bradjc/thermostat/README.md

thermostat
==========

Hardware and software for interfacing an 802.15.4 radio with a Nest thermostat and Liebert Mini-mate cooling unit.
