bradjc/thermostat/tinyos/apps/NestPassThrough/README

Program the NIB so that button presses on the thermostats work like they always
have.
