bradjc/thermostat/docs/ffc_thru-hole_10pos_0.100in.pdf

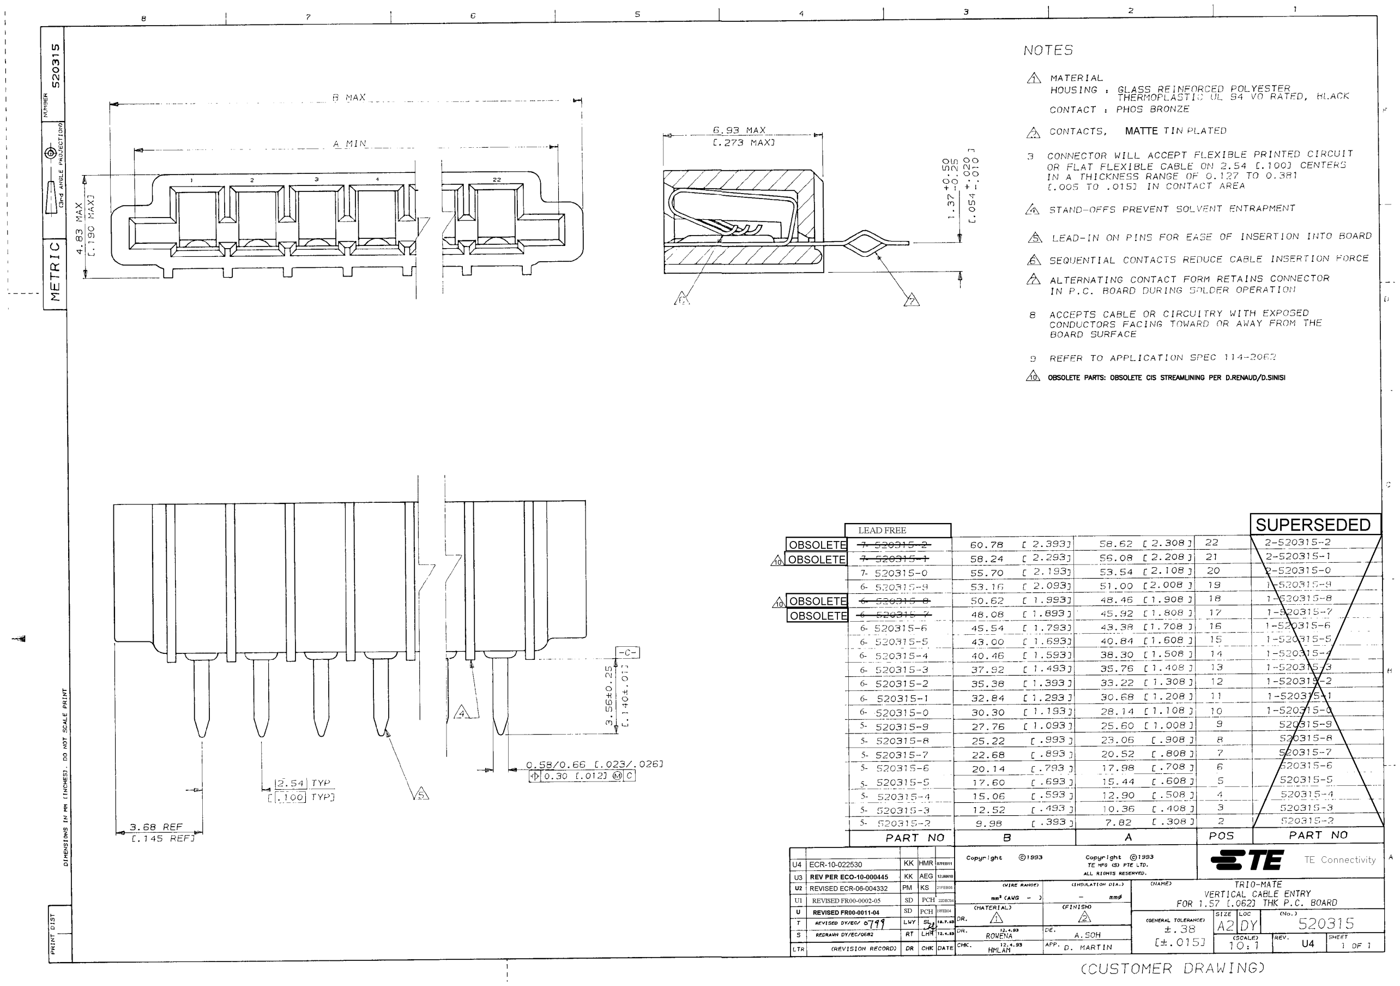
[picture p1: page 1]
