bradjc/thermostat/eagle/nest_interface/rev_a/nest_interface_a_mm.dxf

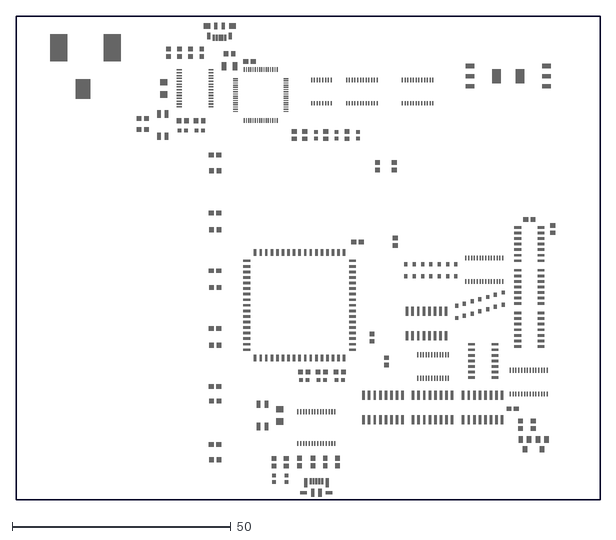
[picture p2: CAD file, 2013-02-01, an earlier design]
eagle/nest_interface/rev_a/nest_interface_a_mm.dxf
133.3 x 110.5
