bradjc/thermostat/eagle/nest_interface/rev_a/nest_interface_a.brd

## EAGLE design eagle/nest_interface/rev_a/nest_interface_a.brd (2013-02-01, an earlier design)

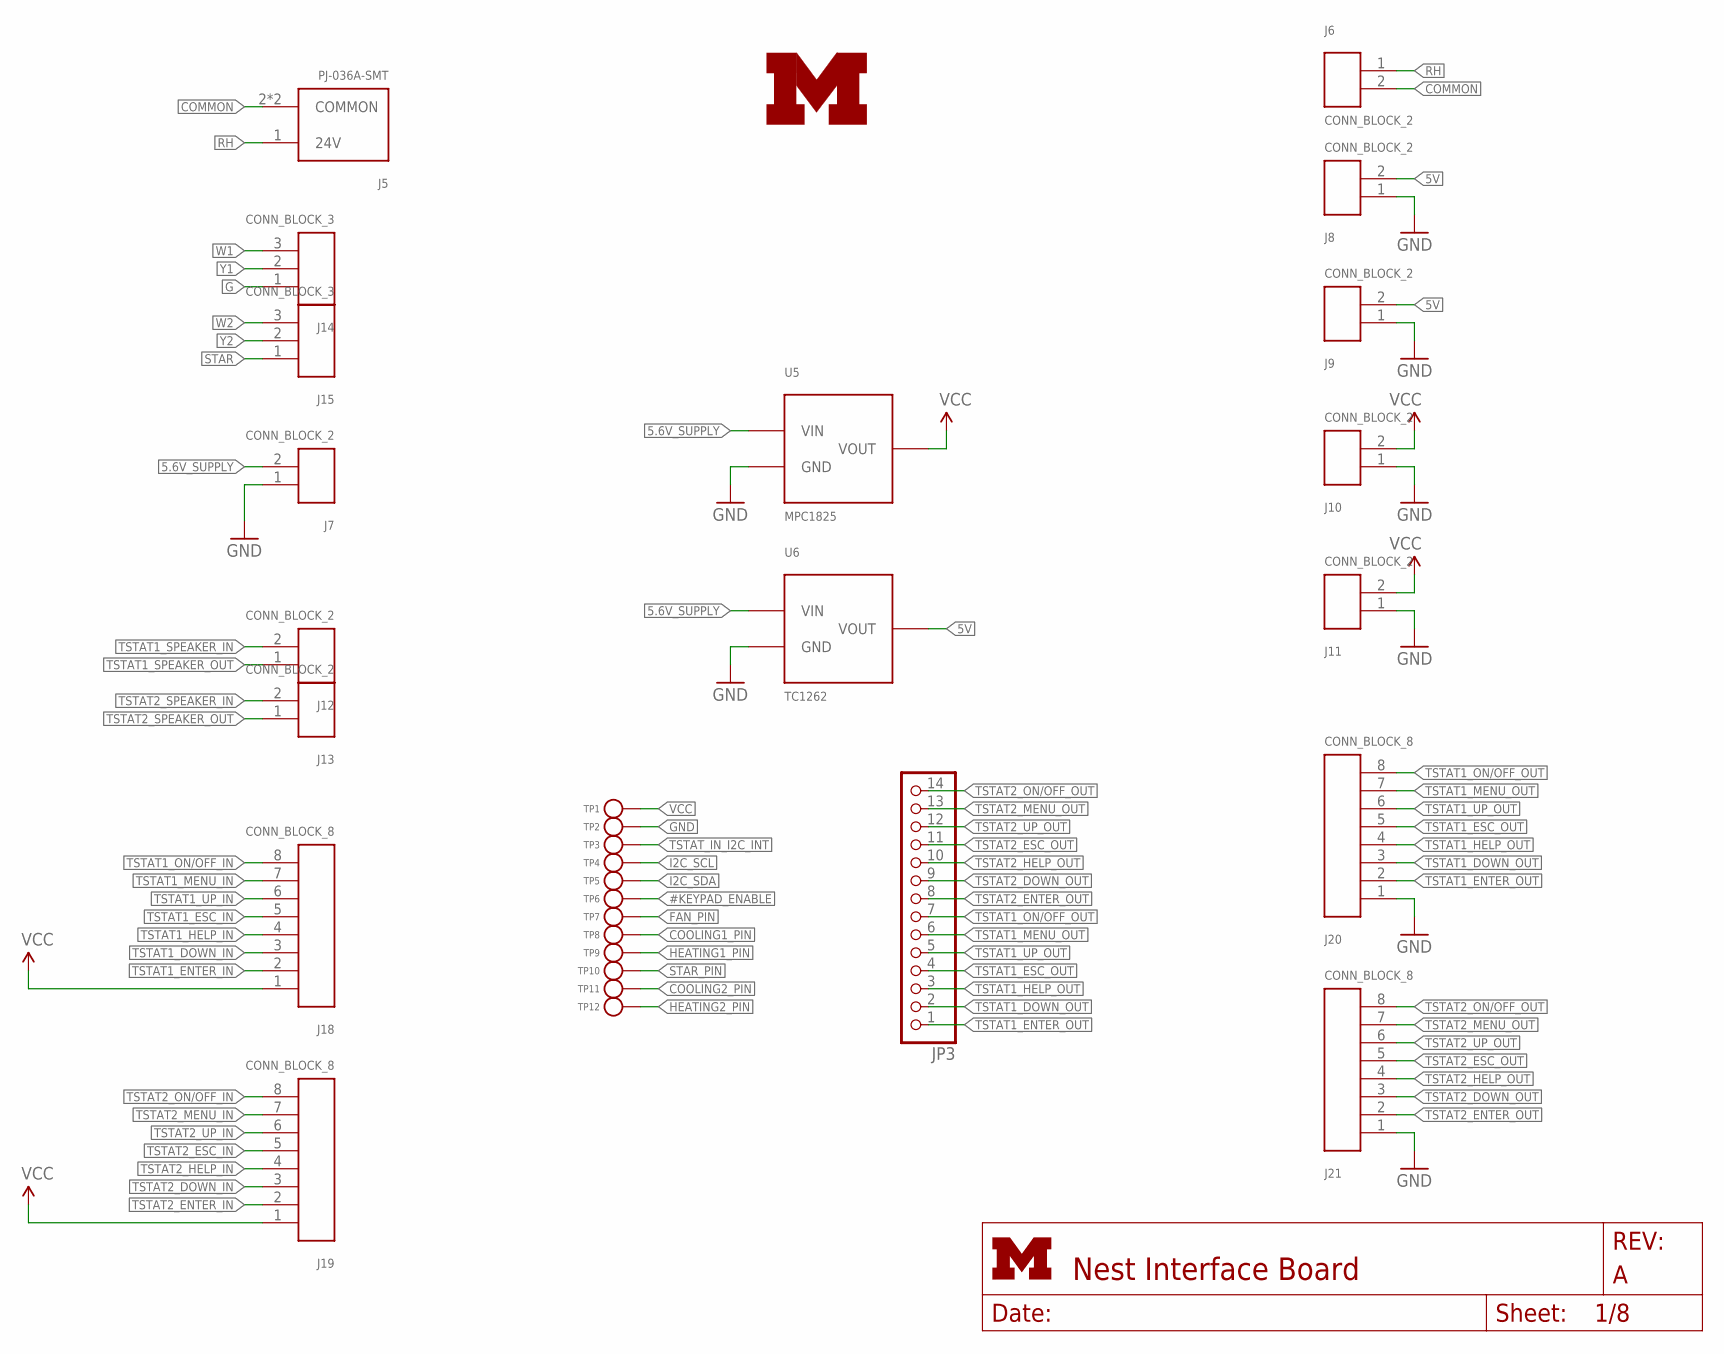
[picture p3: schematic nest_interface_a.sch, sheet 1]

Parts:
J5: PJ-036A-SMT; PJ-0361-SMT
J6, J7, J8, J9, J10, J11, J12, J13: CONN_BLOCK_2
J14, J15: CONN_BLOCK_3
J18, J19, J20, J21: CONN_BLOCK_8
JP3: PINHD-1X14; 1X14
TP1, TP2, TP3, TP4, TP5, TP6, TP7, TP8, TP9, TP10, TP11, TP12: TEST_POINT_0.040IN; TESTPOINT_0.040IN
U5: MPC1825; SOT-223-3
U6: TC1262; SOT-223-3
U$1: UMICH_SOLID_LARGE; UMICH_SOLID_350MIL

Connections:
5.6V_SUPPLY: J7.2, U5.1 (VIN), U6.1 (VIN)
5V: J8.2, J9.2, U6.3 (VOUT)
#KEYPAD_ENABLE: TP6.TESTPOINT; also elsewhere on the board
COMMON: J5.2 (COMMON), J5.3 (COMMON), J6.2; also elsewhere on the board
COOLING1_PIN: TP8.TESTPOINT; also elsewhere on the board
COOLING2_PIN: TP11.TESTPOINT; also elsewhere on the board
FAN_PIN: TP7.TESTPOINT; also elsewhere on the board
G: J14.1; also elsewhere on the board
GND: J7.1, J8.1, J9.1, J10.1, J11.1, J20.1, J21.1, TP2.TESTPOINT, U5.2 (GND), U5.4 (GND), U6.2 (GND), U6.4 (GND); also elsewhere on the board
HEATING1_PIN: TP9.TESTPOINT; also elsewhere on the board
HEATING2_PIN: TP12.TESTPOINT; also elsewhere on the board
I2C_SCL: TP4.TESTPOINT; also elsewhere on the board
I2C_SDA: TP5.TESTPOINT; also elsewhere on the board
RH: J5.1 (24V), J6.1
STAR: J15.1; also elsewhere on the board
STAR_PIN: TP10.TESTPOINT; also elsewhere on the board
TSTAT1_DOWN_IN: J18.3; also elsewhere on the board
TSTAT1_DOWN_OUT: J20.3, JP3.2; also elsewhere on the board
TSTAT1_ENTER_IN: J18.2; also elsewhere on the board
TSTAT1_ENTER_OUT: J20.2, JP3.1; also elsewhere on the board
TSTAT1_ESC_IN: J18.5; also elsewhere on the board
TSTAT1_ESC_OUT: J20.5, JP3.4; also elsewhere on the board
TSTAT1_HELP_IN: J18.4; also elsewhere on the board
TSTAT1_HELP_OUT: J20.4, JP3.3; also elsewhere on the board
TSTAT1_MENU_IN: J18.7; also elsewhere on the board
TSTAT1_MENU_OUT: J20.7, JP3.6; also elsewhere on the board
TSTAT1_ON/OFF_IN: J18.8; also elsewhere on the board
TSTAT1_ON/OFF_OUT: J20.8, JP3.7; also elsewhere on the board
TSTAT1_SPEAKER_IN: J12.2; also elsewhere on the board
TSTAT1_SPEAKER_OUT: J12.1; also elsewhere on the board
TSTAT1_UP_IN: J18.6; also elsewhere on the board
TSTAT1_UP_OUT: J20.6, JP3.5; also elsewhere on the board
TSTAT2_DOWN_IN: J19.3; also elsewhere on the board
TSTAT2_DOWN_OUT: J21.3, JP3.9; also elsewhere on the board
TSTAT2_ENTER_IN: J19.2; also elsewhere on the board
TSTAT2_ENTER_OUT: J21.2, JP3.8; also elsewhere on the board
TSTAT2_ESC_IN: J19.5; also elsewhere on the board
TSTAT2_ESC_OUT: J21.5, JP3.11; also elsewhere on the board
TSTAT2_HELP_IN: J19.4; also elsewhere on the board
TSTAT2_HELP_OUT: J21.4, JP3.10; also elsewhere on the board
TSTAT2_MENU_IN: J19.7; also elsewhere on the board
TSTAT2_MENU_OUT: J21.7, JP3.13; also elsewhere on the board
TSTAT2_ON/OFF_IN: J19.8; also elsewhere on the board
TSTAT2_ON/OFF_OUT: J21.8, JP3.14; also elsewhere on the board
TSTAT2_SPEAKER_IN: J13.2; also elsewhere on the board
TSTAT2_SPEAKER_OUT: J13.1; also elsewhere on the board
TSTAT2_UP_IN: J19.6; also elsewhere on the board
TSTAT2_UP_OUT: J21.6, JP3.12; also elsewhere on the board
TSTAT_IN_I2C_INT: TP3.TESTPOINT; also elsewhere on the board
VCC: J10.2, J11.2, J18.1, J19.1, TP1.TESTPOINT, U5.3 (VOUT); also elsewhere on the board
W1: J14.3; also elsewhere on the board
W2: J15.3; also elsewhere on the board
Y1: J14.2; also elsewhere on the board
Y2: J15.2; also elsewhere on the board

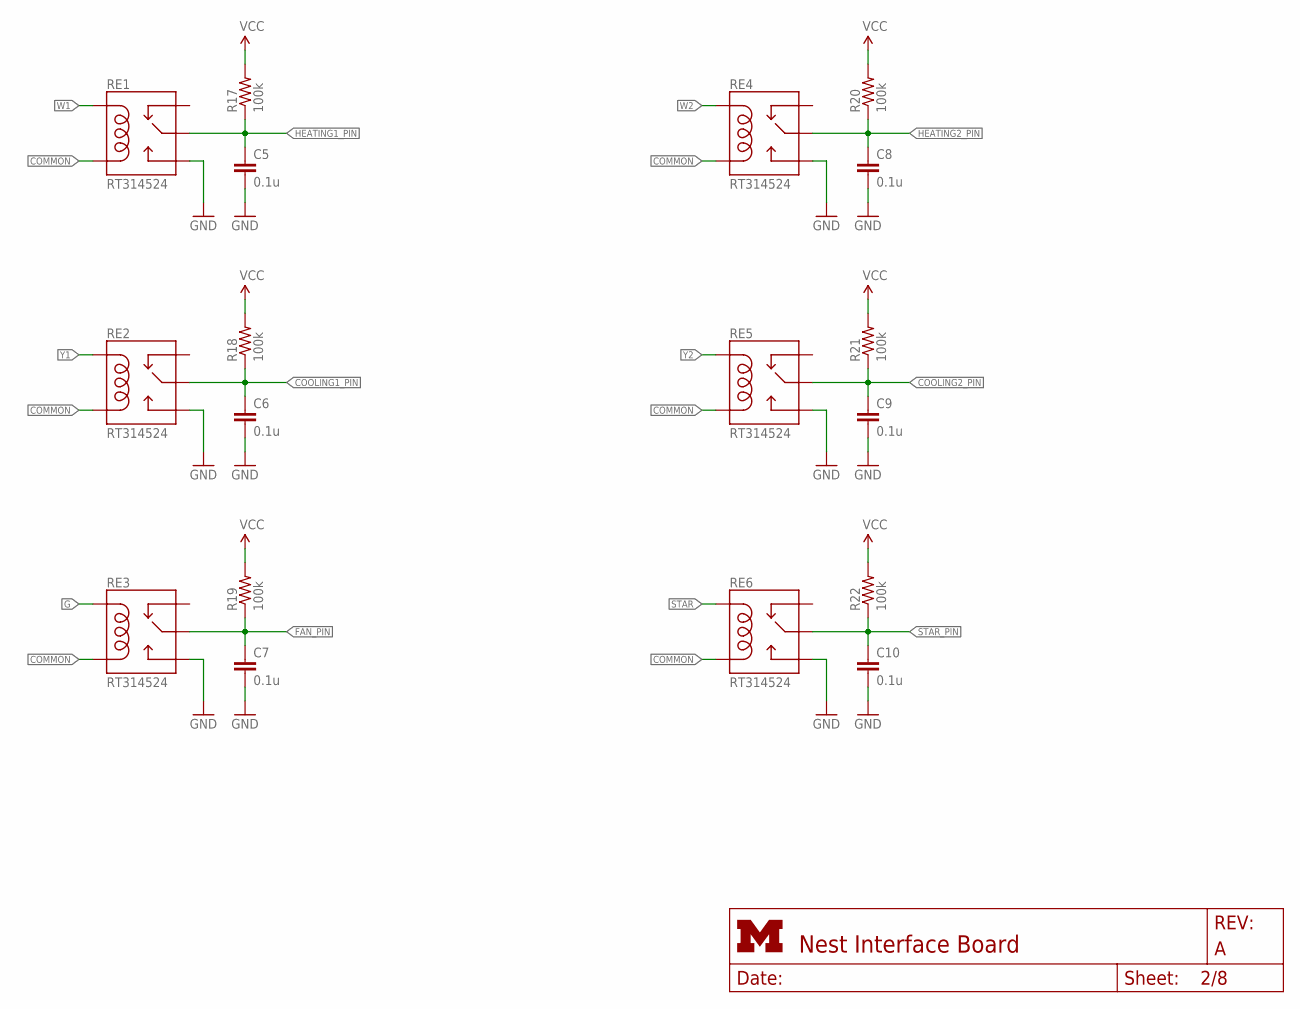
[picture p4: schematic nest_interface_a.sch, sheet 2, Relays]

Parts:
C5, C6, C7, C8, C9, C10: 0.1u; C0603
R17, R18, R19, R20, R21, R22: 100k; R0603
RE1, RE2, RE3, RE4, RE5, RE6: RT314524; S0418-CA

Connections:
COMMON: RE1.A2 (COIL2), RE2.A2 (COIL2), RE3.A2 (COIL2), RE4.A2 (COIL2), RE5.A2 (COIL2), RE6.A2 (COIL2); also elsewhere on the board
COOLING1_PIN: C6.1, R18.1, RE2.COMMON1 (MAIN), RE2.COMMON2 (MAIN); also elsewhere on the board
COOLING2_PIN: C9.1, R21.1, RE5.COMMON1 (MAIN), RE5.COMMON2 (MAIN); also elsewhere on the board
FAN_PIN: C7.1, R19.1, RE3.COMMON1 (MAIN), RE3.COMMON2 (MAIN); also elsewhere on the board
G: RE3.A1 (COIL1); also elsewhere on the board
GND: C5.2, C6.2, C7.2, C8.2, C9.2, C10.2, RE1.NO1 (NO), RE1.NO2 (NO), RE2.NO1 (NO), RE2.NO2 (NO), RE3.NO1 (NO), RE3.NO2 (NO), RE4.NO1 (NO), RE4.NO2 (NO), RE5.NO1 (NO), RE5.NO2 (NO), RE6.NO1 (NO), RE6.NO2 (NO); also elsewhere on the board
HEATING1_PIN: C5.1, R17.1, RE1.COMMON1 (MAIN), RE1.COMMON2 (MAIN); also elsewhere on the board
HEATING2_PIN: C8.1, R20.1, RE4.COMMON1 (MAIN), RE4.COMMON2 (MAIN); also elsewhere on the board
STAR: RE6.A1 (COIL1); also elsewhere on the board
STAR_PIN: C10.1, R22.1, RE6.COMMON1 (MAIN), RE6.COMMON2 (MAIN); also elsewhere on the board
VCC: R17.2, R18.2, R19.2, R20.2, R21.2, R22.2; also elsewhere on the board
W1: RE1.A1 (COIL1); also elsewhere on the board
W2: RE4.A1 (COIL1); also elsewhere on the board
Y1: RE2.A1 (COIL1); also elsewhere on the board
Y2: RE5.A1 (COIL1); also elsewhere on the board

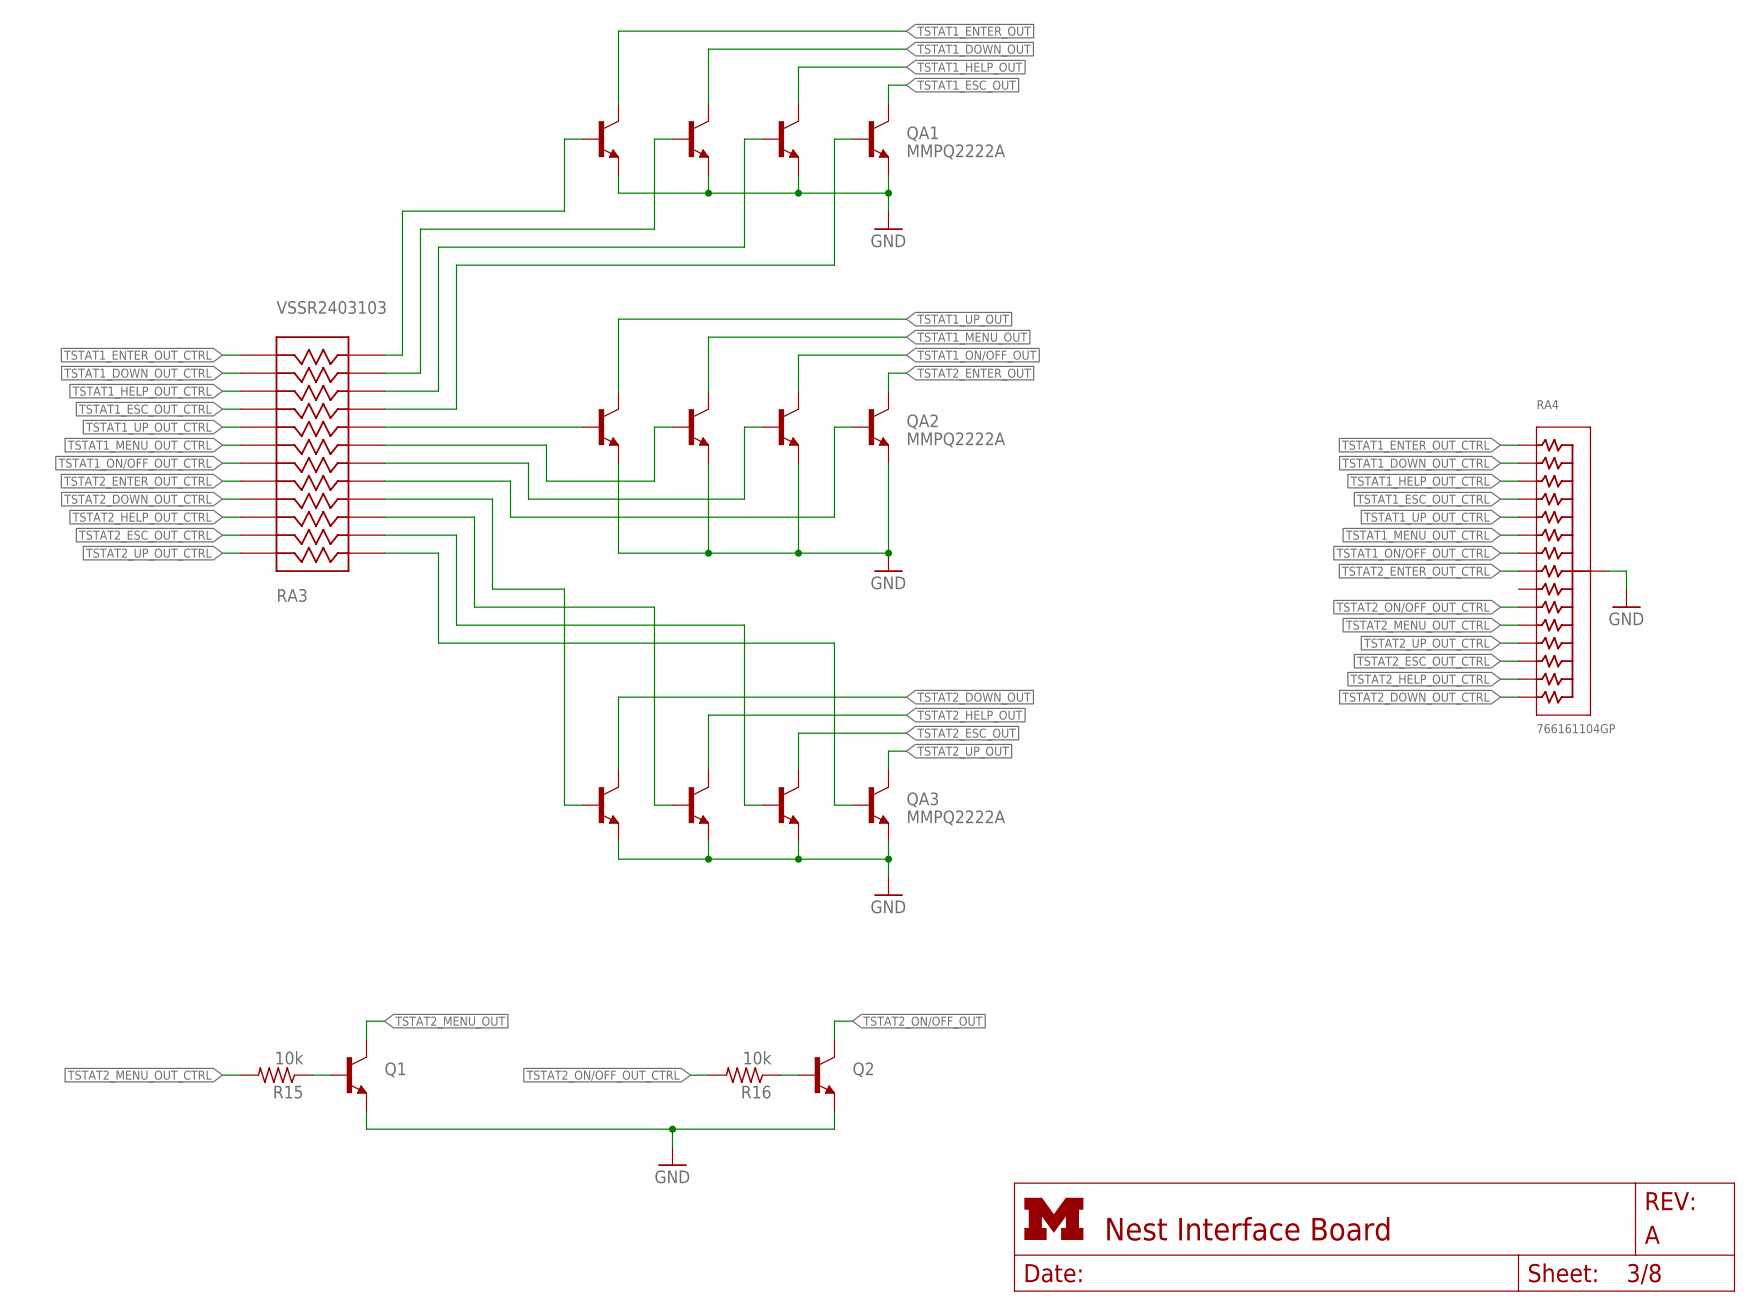
[picture p5: schematic nest_interface_a.sch, sheet 3, Wire interfacing]

Parts:
Q1, Q2: TRANSISTOR_NPNSOT23; SOT23; DIGIKEY 568-1636-1-ND
QA1, QA3: MMPQ2222A; SOIC-16; DIGIKEY MMPQ2222ACT-ND
QA2: MMPQ2222A; SOIC-16
R15, R16: 10k; R0603
RA3: VSSR2403103; LSSOP-24
RA4: 766161104GP; SOIC-16

Connections:
GND: Q1.2 (E), Q2.2 (E), QA1.10 (E4), QA1.12 (E3), QA1.14 (E2), QA1.16 (E1), QA2.10 (E4), QA2.12 (E3), QA2.14 (E2), QA2.16 (E1), QA3.10 (E4), QA3.12 (E3), QA3.14 (E2), QA3.16 (E1), RA4.16 (OUT); also elsewhere on the board
unnamed: QA2.11 (B3), RA3.19
unnamed: QA1.13 (B2), RA3.14
unnamed: QA1.11 (B3), RA3.15
unnamed: QA1.9 (B4), RA3.16
unnamed: QA3.9 (B4), RA3.24
unnamed: QA3.15 (B1), RA3.21
unnamed: QA3.13 (B2), RA3.22
unnamed: QA3.11 (B3), RA3.23
unnamed: Q1.1 (B), R15.1
unnamed: Q2.1 (B), R16.1
unnamed: QA1.15 (B1), RA3.13
unnamed: QA2.15 (B1), RA3.17
unnamed: QA2.9 (B4), RA3.20
unnamed: QA2.13 (B2), RA3.18
TSTAT1_DOWN_OUT: QA1.3 (C2), QA1.4 (C2); also elsewhere on the board
TSTAT1_DOWN_OUT_CTRL: RA3.11, RA4.2; also elsewhere on the board
TSTAT1_ENTER_OUT: QA1.1 (C1), QA1.2 (C1); also elsewhere on the board
TSTAT1_ENTER_OUT_CTRL: RA3.12, RA4.1; also elsewhere on the board
TSTAT1_ESC_OUT: QA1.7 (C4), QA1.8 (C4); also elsewhere on the board
TSTAT1_ESC_OUT_CTRL: RA3.9, RA4.4; also elsewhere on the board
TSTAT1_HELP_OUT: QA1.5 (C3), QA1.6 (C3); also elsewhere on the board
TSTAT1_HELP_OUT_CTRL: RA3.10, RA4.3; also elsewhere on the board
TSTAT1_MENU_OUT: QA2.3 (C2), QA2.4 (C2); also elsewhere on the board
TSTAT1_MENU_OUT_CTRL: RA3.7, RA4.6; also elsewhere on the board
TSTAT1_ON/OFF_OUT: QA2.5 (C3), QA2.6 (C3); also elsewhere on the board
TSTAT1_ON/OFF_OUT_CTRL: RA3.6, RA4.7; also elsewhere on the board
TSTAT1_UP_OUT: QA2.1 (C1), QA2.2 (C1); also elsewhere on the board
TSTAT1_UP_OUT_CTRL: RA3.8, RA4.5; also elsewhere on the board
TSTAT2_DOWN_OUT: QA3.1 (C1), QA3.2 (C1); also elsewhere on the board
TSTAT2_DOWN_OUT_CTRL: RA3.4, RA4.15; also elsewhere on the board
TSTAT2_ENTER_OUT: QA2.7 (C4), QA2.8 (C4); also elsewhere on the board
TSTAT2_ENTER_OUT_CTRL: RA3.5, RA4.8; also elsewhere on the board
TSTAT2_ESC_OUT: QA3.5 (C3), QA3.6 (C3); also elsewhere on the board
TSTAT2_ESC_OUT_CTRL: RA3.2, RA4.13; also elsewhere on the board
TSTAT2_HELP_OUT: QA3.3 (C2), QA3.4 (C2); also elsewhere on the board
TSTAT2_HELP_OUT_CTRL: RA3.3, RA4.14; also elsewhere on the board
TSTAT2_MENU_OUT: Q1.3 (C); also elsewhere on the board
TSTAT2_MENU_OUT_CTRL: R15.2, RA4.11; also elsewhere on the board
TSTAT2_ON/OFF_OUT: Q2.3 (C); also elsewhere on the board
TSTAT2_ON/OFF_OUT_CTRL: R16.2, RA4.10; also elsewhere on the board
TSTAT2_UP_OUT: QA3.7 (C4), QA3.8 (C4); also elsewhere on the board
TSTAT2_UP_OUT_CTRL: RA3.1, RA4.12; also elsewhere on the board

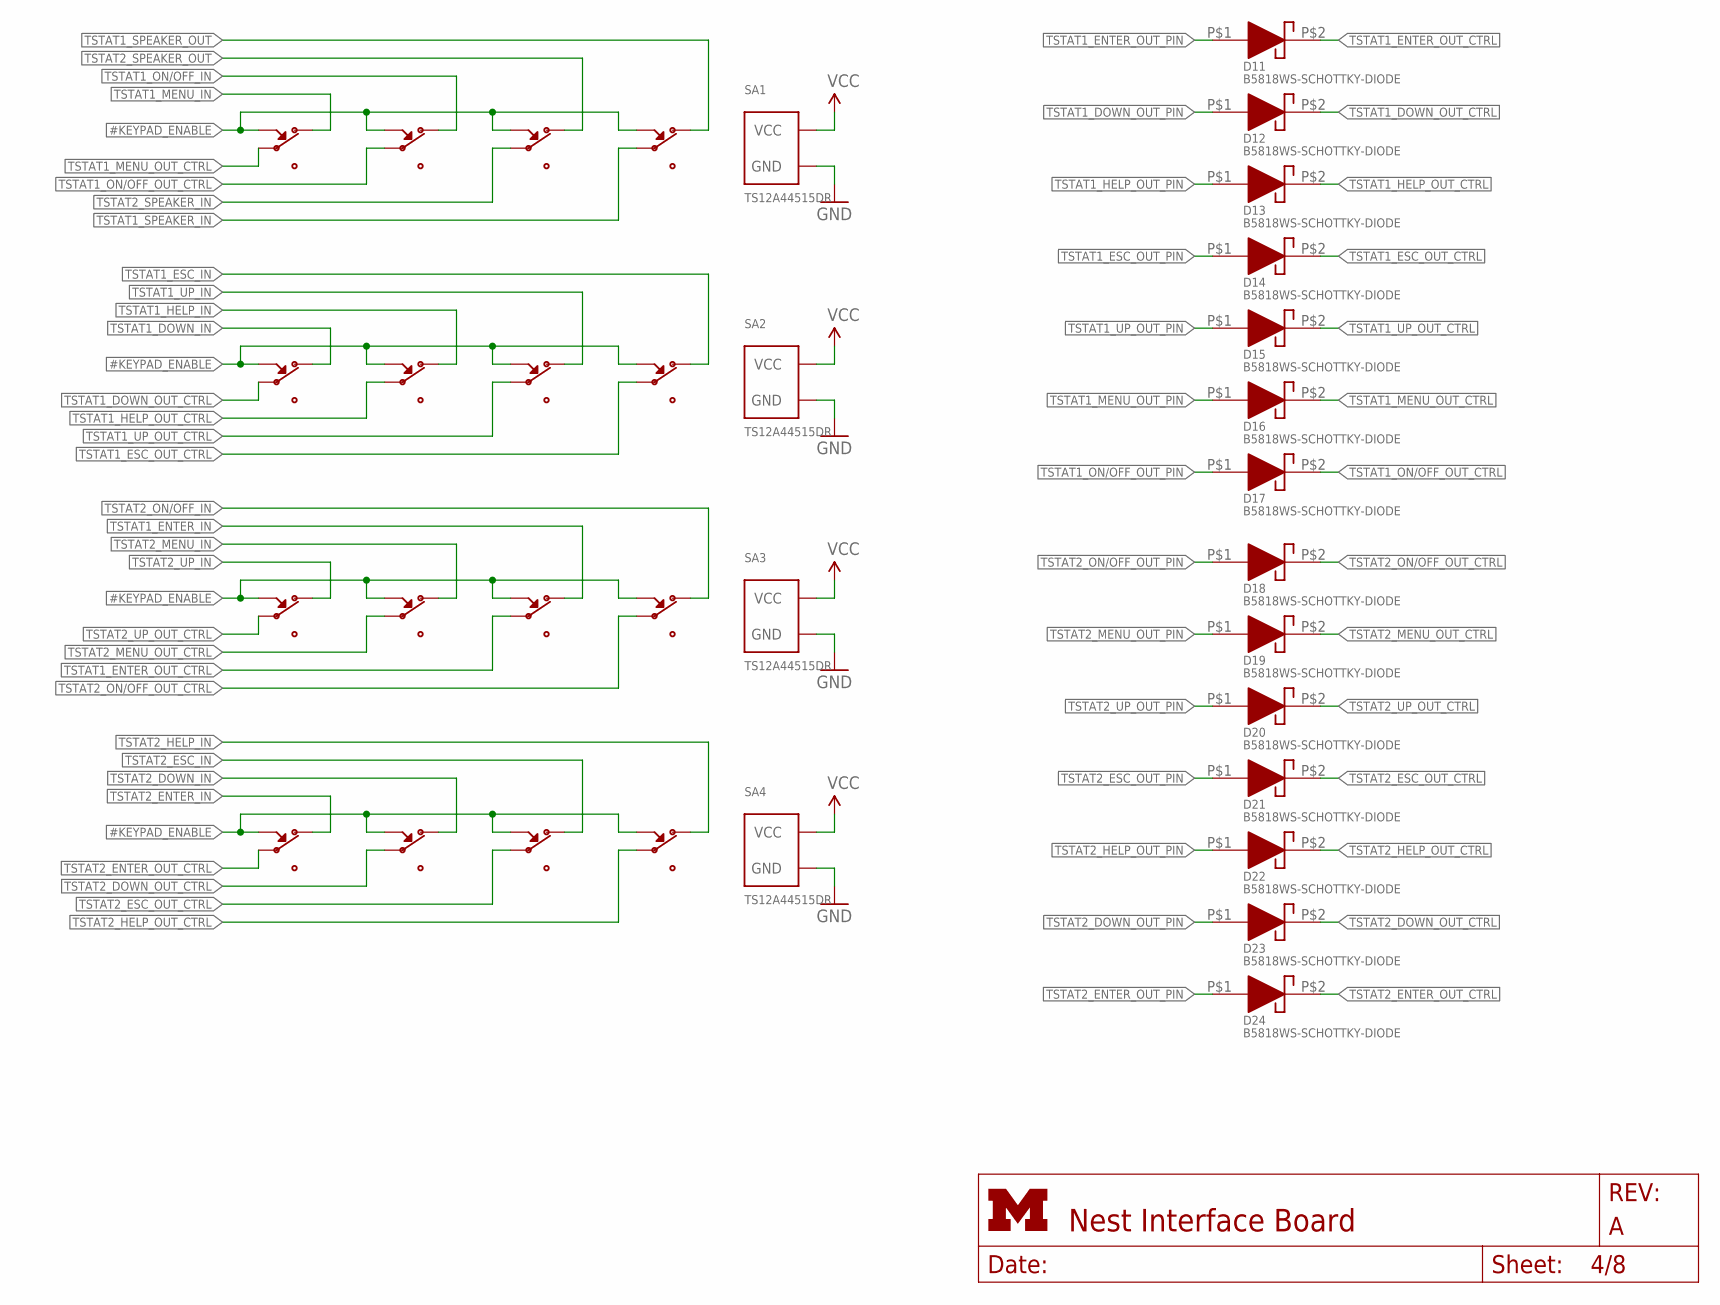
[picture p6: schematic nest_interface_a.sch, sheet 4, Input buttons from thermostat]

Parts:
D11, D12, D13, D14, D15, D16, D17, D18, D19, D20, D21, D22, D23, D24: B5818WS-SCHOTTKY-DIODE; SOD-323
SA1, SA2, SA3, SA4: TS12A44515DR; SOIC-14

Connections:
#KEYPAD_ENABLE: SA1.5 (IN2), SA1.6 (IN3), SA1.12 (IN4), SA1.13 (IN1), SA2.5 (IN2), SA2.6 (IN3), SA2.12 (IN4), SA2.13 (IN1), SA3.5 (IN2), SA3.6 (IN3), SA3.12 (IN4), SA3.13 (IN1), SA4.5 (IN2), SA4.6 (IN3), SA4.12 (IN4), SA4.13 (IN1); also elsewhere on the board
GND: SA1.7 (GND), SA2.7 (GND), SA3.7 (GND), SA4.7 (GND); also elsewhere on the board
TSTAT1_DOWN_IN: SA2.1 (NC1); also elsewhere on the board
TSTAT1_DOWN_OUT_CTRL: D12.P$2 (C), SA2.2 (COM1); also elsewhere on the board
TSTAT1_DOWN_OUT_PIN: D12.P$1 (A); also elsewhere on the board
TSTAT1_ENTER_IN: SA3.8 (NC3); also elsewhere on the board
TSTAT1_ENTER_OUT_CTRL: D11.P$2 (C), SA3.9 (COM3); also elsewhere on the board
TSTAT1_ENTER_OUT_PIN: D11.P$1 (A); also elsewhere on the board
TSTAT1_ESC_IN: SA2.11 (NC4); also elsewhere on the board
TSTAT1_ESC_OUT_CTRL: D14.P$2 (C), SA2.10 (COM4); also elsewhere on the board
TSTAT1_ESC_OUT_PIN: D14.P$1 (A); also elsewhere on the board
TSTAT1_HELP_IN: SA2.3 (NC2); also elsewhere on the board
TSTAT1_HELP_OUT_CTRL: D13.P$2 (C), SA2.4 (COM2); also elsewhere on the board
TSTAT1_HELP_OUT_PIN: D13.P$1 (A); also elsewhere on the board
TSTAT1_MENU_IN: SA1.1 (NC1); also elsewhere on the board
TSTAT1_MENU_OUT_CTRL: D16.P$2 (C), SA1.2 (COM1); also elsewhere on the board
TSTAT1_MENU_OUT_PIN: D16.P$1 (A); also elsewhere on the board
TSTAT1_ON/OFF_IN: SA1.3 (NC2); also elsewhere on the board
TSTAT1_ON/OFF_OUT_CTRL: D17.P$2 (C), SA1.4 (COM2); also elsewhere on the board
TSTAT1_ON/OFF_OUT_PIN: D17.P$1 (A); also elsewhere on the board
TSTAT1_SPEAKER_IN: SA1.10 (COM4); also elsewhere on the board
TSTAT1_SPEAKER_OUT: SA1.11 (NC4); also elsewhere on the board
TSTAT1_UP_IN: SA2.8 (NC3); also elsewhere on the board
TSTAT1_UP_OUT_CTRL: D15.P$2 (C), SA2.9 (COM3); also elsewhere on the board
TSTAT1_UP_OUT_PIN: D15.P$1 (A); also elsewhere on the board
TSTAT2_DOWN_IN: SA4.3 (NC2); also elsewhere on the board
TSTAT2_DOWN_OUT_CTRL: D23.P$2 (C), SA4.4 (COM2); also elsewhere on the board
TSTAT2_DOWN_OUT_PIN: D23.P$1 (A); also elsewhere on the board
TSTAT2_ENTER_IN: SA4.1 (NC1); also elsewhere on the board
TSTAT2_ENTER_OUT_CTRL: D24.P$2 (C), SA4.2 (COM1); also elsewhere on the board
TSTAT2_ENTER_OUT_PIN: D24.P$1 (A); also elsewhere on the board
TSTAT2_ESC_IN: SA4.8 (NC3); also elsewhere on the board
TSTAT2_ESC_OUT_CTRL: D21.P$2 (C), SA4.9 (COM3); also elsewhere on the board
TSTAT2_ESC_OUT_PIN: D21.P$1 (A); also elsewhere on the board
TSTAT2_HELP_IN: SA4.11 (NC4); also elsewhere on the board
TSTAT2_HELP_OUT_CTRL: D22.P$2 (C), SA4.10 (COM4); also elsewhere on the board
TSTAT2_HELP_OUT_PIN: D22.P$1 (A); also elsewhere on the board
TSTAT2_MENU_IN: SA3.3 (NC2); also elsewhere on the board
TSTAT2_MENU_OUT_CTRL: D19.P$2 (C), SA3.4 (COM2); also elsewhere on the board
TSTAT2_MENU_OUT_PIN: D19.P$1 (A); also elsewhere on the board
TSTAT2_ON/OFF_IN: SA3.11 (NC4); also elsewhere on the board
TSTAT2_ON/OFF_OUT_CTRL: D18.P$2 (C), SA3.10 (COM4); also elsewhere on the board
TSTAT2_ON/OFF_OUT_PIN: D18.P$1 (A); also elsewhere on the board
TSTAT2_SPEAKER_IN: SA1.9 (COM3); also elsewhere on the board
TSTAT2_SPEAKER_OUT: SA1.8 (NC3); also elsewhere on the board
TSTAT2_UP_IN: SA3.1 (NC1); also elsewhere on the board
TSTAT2_UP_OUT_CTRL: D20.P$2 (C), SA3.2 (COM1); also elsewhere on the board
TSTAT2_UP_OUT_PIN: D20.P$1 (A); also elsewhere on the board
VCC: SA1.14 (VCC), SA2.14 (VCC), SA3.14 (VCC), SA4.14 (VCC); also elsewhere on the board

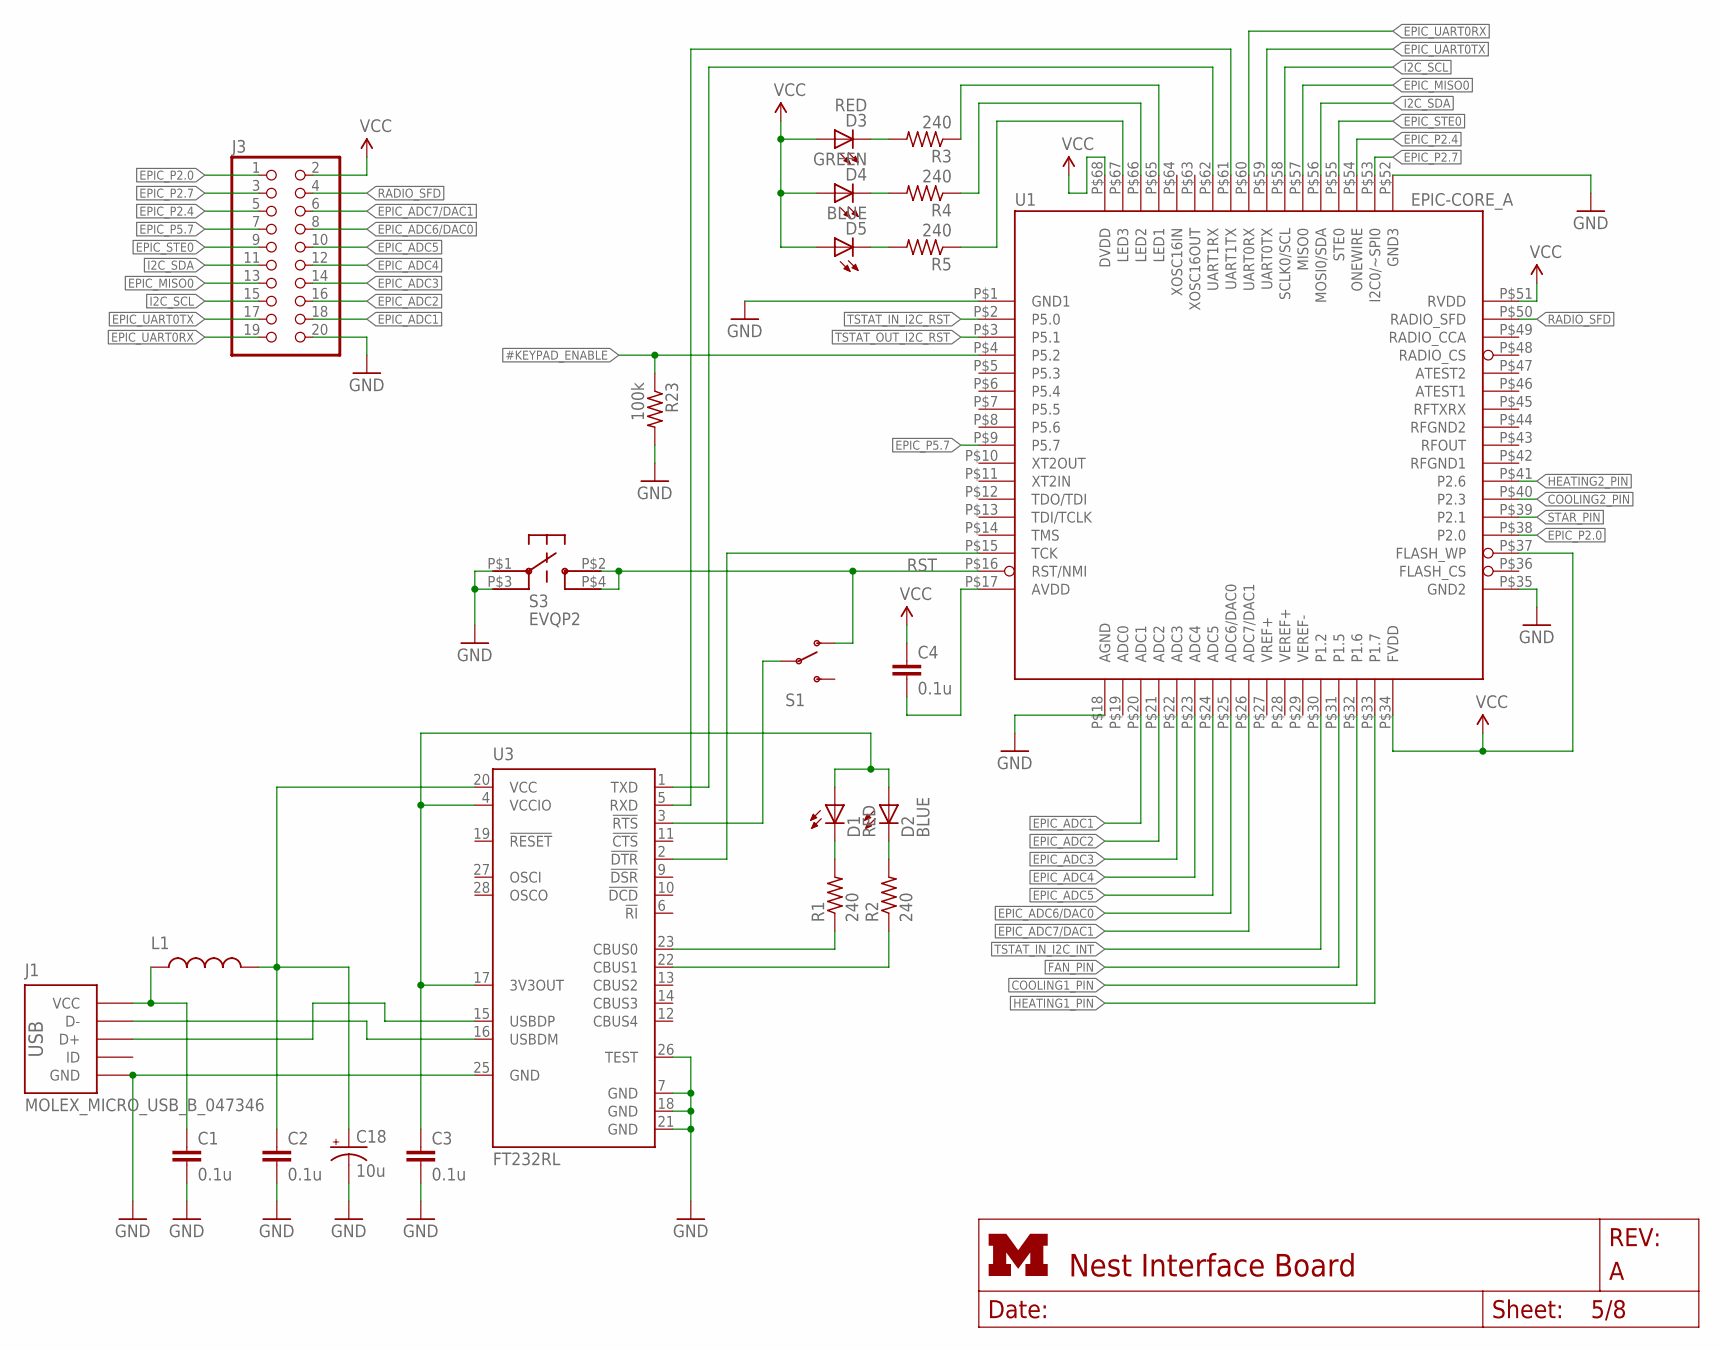
[picture p7: schematic nest_interface_a.sch, sheet 5, EPIC and programming circuit]

Parts:
C1, C2, C3, C4: 0.1u; C0603
C18: 10u; EIA3216; DIGIKEY 478-1655-1-ND
D1, D3: RED; LED-0603
D2, D5: BLUE; LED-0603
D4: GREEN; LED-0603
J1: MOLEX_MICRO_USB_B_047346
J3: PINHD-2X10; 2X10
L1: INDUCTOR0603; 0603; DIGIKEY 240-2373-1-ND
R1, R2, R3, R4, R5: 240; R0603
R23: 100k; R0603
S1: SWITCH-SPSTPTH; SWITCH-SPDT; DIGIKEY EG1903-ND
S3: EVQP2; DIGIKEY P11084SCT-ND
U1: EPIC-CORE_A; EPIC-LCC68
U3: FT232RL; SSOP28; DIGIKEY 768-1007-1-ND

Connections:
#KEYPAD_ENABLE: R23.1, U1.P$4 (P5.2); also elsewhere on the board
COOLING1_PIN: U1.P$32 (P1.6); also elsewhere on the board
COOLING2_PIN: U1.P$40 (P2.3); also elsewhere on the board
EPIC_ADC1: J3.18, U1.P$20 (ADC1)
EPIC_ADC2: J3.16, U1.P$21 (ADC2)
EPIC_ADC3: J3.14, U1.P$22 (ADC3)
EPIC_ADC4: J3.12, U1.P$23 (ADC4)
EPIC_ADC5: J3.10, U1.P$24 (ADC5)
EPIC_ADC6/DAC0: J3.8, U1.P$25 (ADC6/DAC0)
EPIC_ADC7/DAC1: J3.6, U1.P$26 (ADC7/DAC1)
EPIC_MISO0: J3.13, U1.P$57 (MISO0)
EPIC_P2.0: J3.1, U1.P$38 (P2.0)
EPIC_P2.4: J3.5, U1.P$54 (ONEWIRE)
EPIC_P2.7: J3.3, U1.P$53 (I2C0/~SPI0)
EPIC_P5.7: J3.7, U1.P$9 (P5.7)
EPIC_STE0: J3.9, U1.P$55 (STE0)
EPIC_UART0RX: J3.19, U1.P$60 (UART0RX)
EPIC_UART0TX: J3.17, U1.P$59 (UART0TX)
FAN_PIN: U1.P$31 (P1.5); also elsewhere on the board
GND: C1.2, C2.2, C3.2, C18.C (-), J1.GND, J3.20, R23.2, S3.P$1, S3.P$3, U1.P$1 (GND1), U1.P$18 (AGND), U1.P$35 (GND2), U1.P$52 (GND3), U3.7 (GND), U3.18 (GND), U3.21 (GND), U3.25 (GND), U3.26 (TEST); also elsewhere on the board
HEATING1_PIN: U1.P$33 (P1.7); also elsewhere on the board
HEATING2_PIN: U1.P$41 (P2.6); also elsewhere on the board
I2C_SCL: J3.15, U1.P$58 (SCLK0/SCL); also elsewhere on the board
I2C_SDA: J3.11, U1.P$56 (MOSI0/SDA); also elsewhere on the board
unnamed: C1.1, J1.VCC, L1.1
unnamed: D1.C, R1.2
unnamed: J1.D-, U3.16 (USBDM)
unnamed: J1.D+, U3.15 (USBDP)
unnamed: C2.1, C18.A (+), L1.2, U3.20 (VCC)
unnamed: D2.C, R2.2
unnamed: U1.P$62 (UART1RX), U3.1 (TXD)
unnamed: R1.1, U3.23 (CBUS0)
unnamed: R2.1, U3.22 (CBUS1)
unnamed: U1.P$61 (UART1TX), U3.5 (RXD)
unnamed: U1.P$15 (TCK), U3.2 (!DTR)
unnamed: C3.1, D1.A, D2.A, U3.4 (VCCIO), U3.17 (3V3OUT)
unnamed: C4.2, U1.P$17 (AVDD)
unnamed: D3.C, R3.2
unnamed: D4.C, R4.2
unnamed: D5.C, R5.2
unnamed: R5.1, U1.P$67 (LED3)
unnamed: R4.1, U1.P$66 (LED2)
unnamed: R3.1, U1.P$65 (LED1)
RADIO_SFD: J3.4, U1.P$50 (RADIO_SFD)
RST: S1.1 (O), S3.P$2, S3.P$4, U1.P$16 (RST/NMI)
RST_USB: S1.2, U3.3 (!RTS)
STAR_PIN: U1.P$39 (P2.1); also elsewhere on the board
TSTAT_IN_I2C_INT: U1.P$30 (P1.2); also elsewhere on the board
TSTAT_IN_I2C_RST: U1.P$2 (P5.0); also elsewhere on the board
TSTAT_OUT_I2C_RST: U1.P$3 (P5.1); also elsewhere on the board
VCC: C4.1, D3.A, D4.A, D5.A, J3.2, U1.P$34 (FVDD), U1.P$37 (FLASH_WP), U1.P$51 (RVDD), U1.P$68 (DVDD); also elsewhere on the board

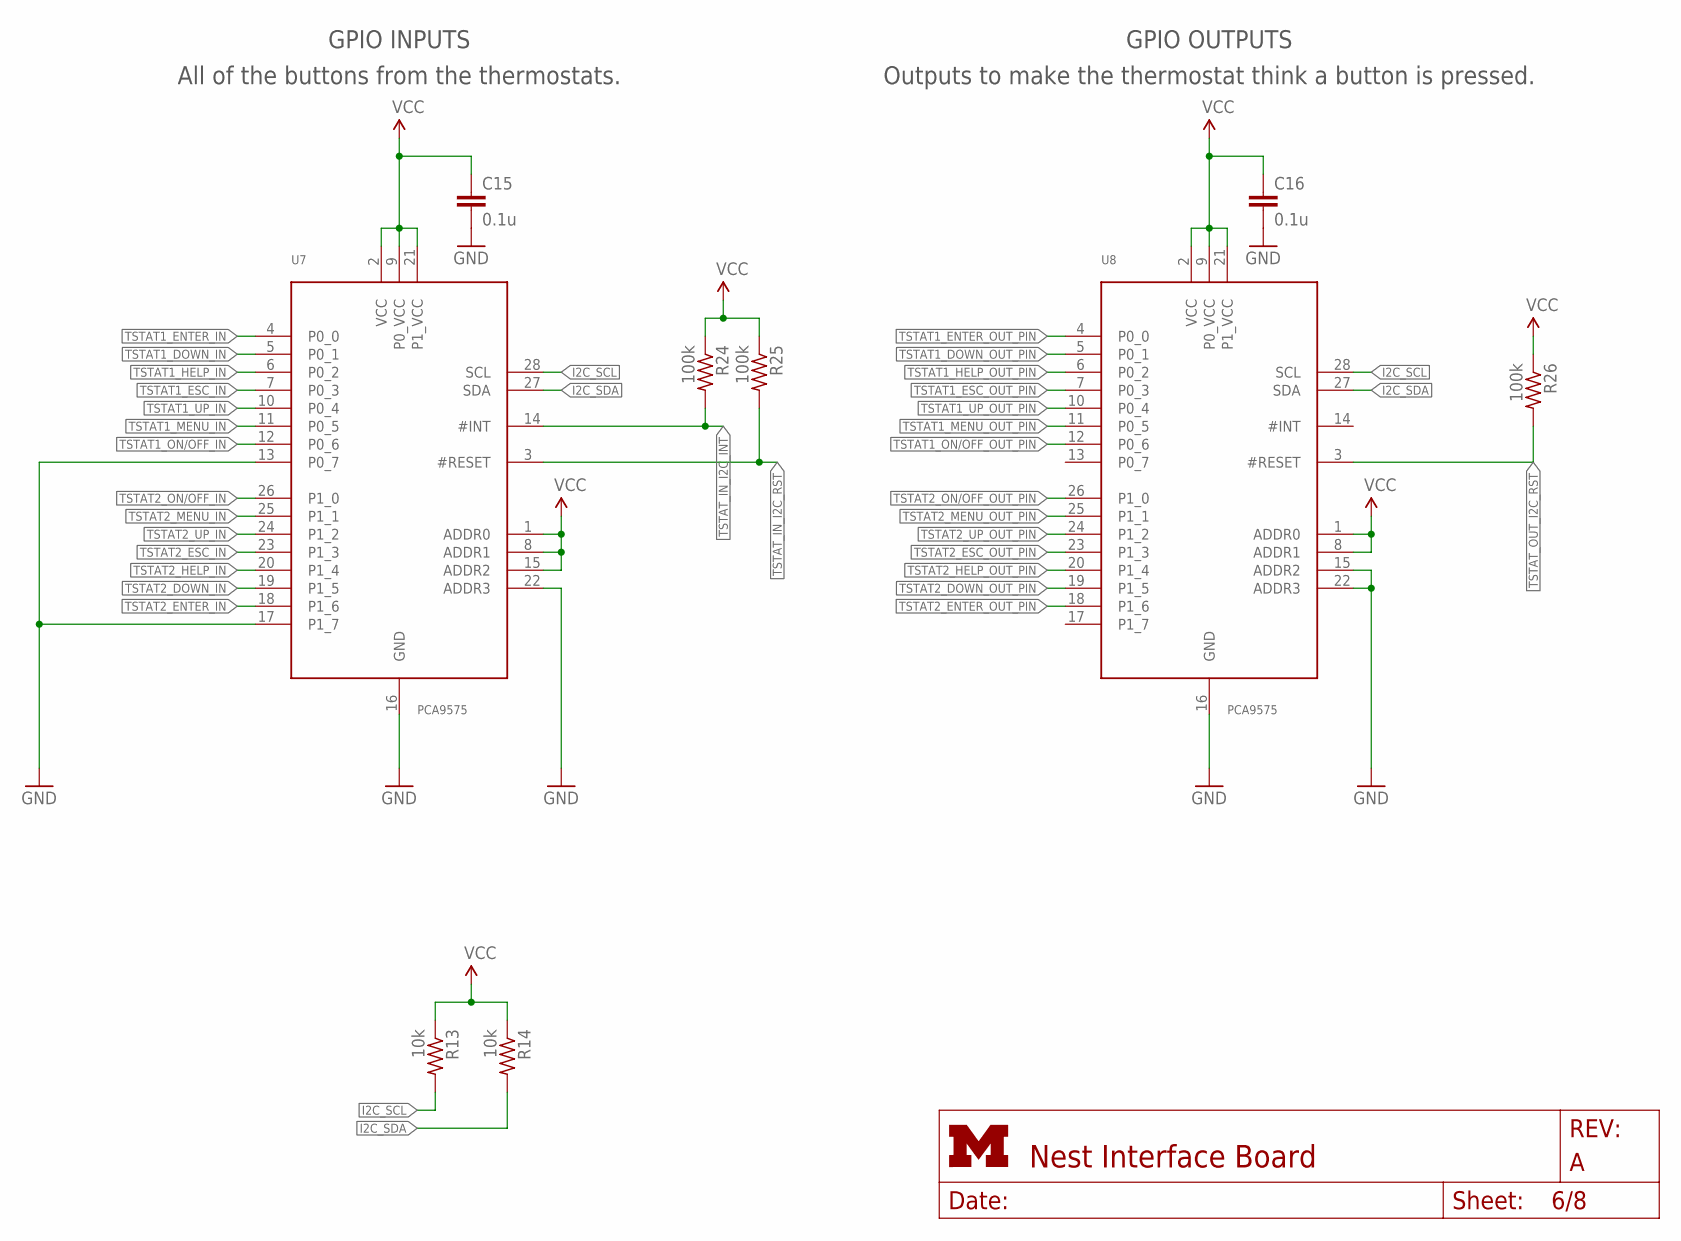
[picture p8: schematic nest_interface_a.sch, sheet 6, GPIO Extenders]

Parts:
C15, C16: 0.1u; C0603
R13, R14: 10k; R0603
R24, R25, R26: 100k; R0603
U7, U8: PCA9575; TSSOP28

Connections:
GND: C15.2, C16.2, U7.13 (P0_7), U7.16 (GND), U7.17 (P1_7), U7.22 (ADDR3), U8.15 (ADDR2), U8.16 (GND), U8.22 (ADDR3); also elsewhere on the board
I2C_SCL: R13.2, U7.28 (SCL), U8.28 (SCL); also elsewhere on the board
I2C_SDA: R14.2, U7.27 (SDA), U8.27 (SDA); also elsewhere on the board
TSTAT1_DOWN_IN: U7.5 (P0_1); also elsewhere on the board
TSTAT1_DOWN_OUT_PIN: U8.5 (P0_1); also elsewhere on the board
TSTAT1_ENTER_IN: U7.4 (P0_0); also elsewhere on the board
TSTAT1_ENTER_OUT_PIN: U8.4 (P0_0); also elsewhere on the board
TSTAT1_ESC_IN: U7.7 (P0_3); also elsewhere on the board
TSTAT1_ESC_OUT_PIN: U8.7 (P0_3); also elsewhere on the board
TSTAT1_HELP_IN: U7.6 (P0_2); also elsewhere on the board
TSTAT1_HELP_OUT_PIN: U8.6 (P0_2); also elsewhere on the board
TSTAT1_MENU_IN: U7.11 (P0_5); also elsewhere on the board
TSTAT1_MENU_OUT_PIN: U8.11 (P0_5); also elsewhere on the board
TSTAT1_ON/OFF_IN: U7.12 (P0_6); also elsewhere on the board
TSTAT1_ON/OFF_OUT_PIN: U8.12 (P0_6); also elsewhere on the board
TSTAT1_UP_IN: U7.10 (P0_4); also elsewhere on the board
TSTAT1_UP_OUT_PIN: U8.10 (P0_4); also elsewhere on the board
TSTAT2_DOWN_IN: U7.19 (P1_5); also elsewhere on the board
TSTAT2_DOWN_OUT_PIN: U8.19 (P1_5); also elsewhere on the board
TSTAT2_ENTER_IN: U7.18 (P1_6); also elsewhere on the board
TSTAT2_ENTER_OUT_PIN: U8.18 (P1_6); also elsewhere on the board
TSTAT2_ESC_IN: U7.23 (P1_3); also elsewhere on the board
TSTAT2_ESC_OUT_PIN: U8.23 (P1_3); also elsewhere on the board
TSTAT2_HELP_IN: U7.20 (P1_4); also elsewhere on the board
TSTAT2_HELP_OUT_PIN: U8.20 (P1_4); also elsewhere on the board
TSTAT2_MENU_IN: U7.25 (P1_1); also elsewhere on the board
TSTAT2_MENU_OUT_PIN: U8.25 (P1_1); also elsewhere on the board
TSTAT2_ON/OFF_IN: U7.26 (P1_0); also elsewhere on the board
TSTAT2_ON/OFF_OUT_PIN: U8.26 (P1_0); also elsewhere on the board
TSTAT2_UP_IN: U7.24 (P1_2); also elsewhere on the board
TSTAT2_UP_OUT_PIN: U8.24 (P1_2); also elsewhere on the board
TSTAT_IN_I2C_INT: R24.2, U7.14 (#INT); also elsewhere on the board
TSTAT_IN_I2C_RST: R25.2, U7.3 (#RESET); also elsewhere on the board
TSTAT_OUT_I2C_RST: R26.2, U8.3 (#RESET); also elsewhere on the board
VCC: C15.1, C16.1, R13.1, R14.1, R24.1, R25.1, R26.1, U7.1 (ADDR0), U7.2 (VCC), U7.8 (ADDR1), U7.9 (P0_VCC), U7.15 (ADDR2), U7.21 (P1_VCC), U8.1 (ADDR0), U8.2 (VCC), U8.8 (ADDR1), U8.9 (P0_VCC), U8.21 (P1_VCC); also elsewhere on the board

Notes on the sheet:
GPIO INPUTS
All of the buttons from the thermostats.
GPIO OUTPUTS
Outputs to make the thermostat think a button is pressed.
