bradjc/thermostat/eagle/nest_interface/rev_a/nest_interface_a.brd

## EAGLE design eagle/nest_interface/rev_a/nest_interface_a.brd (continued)

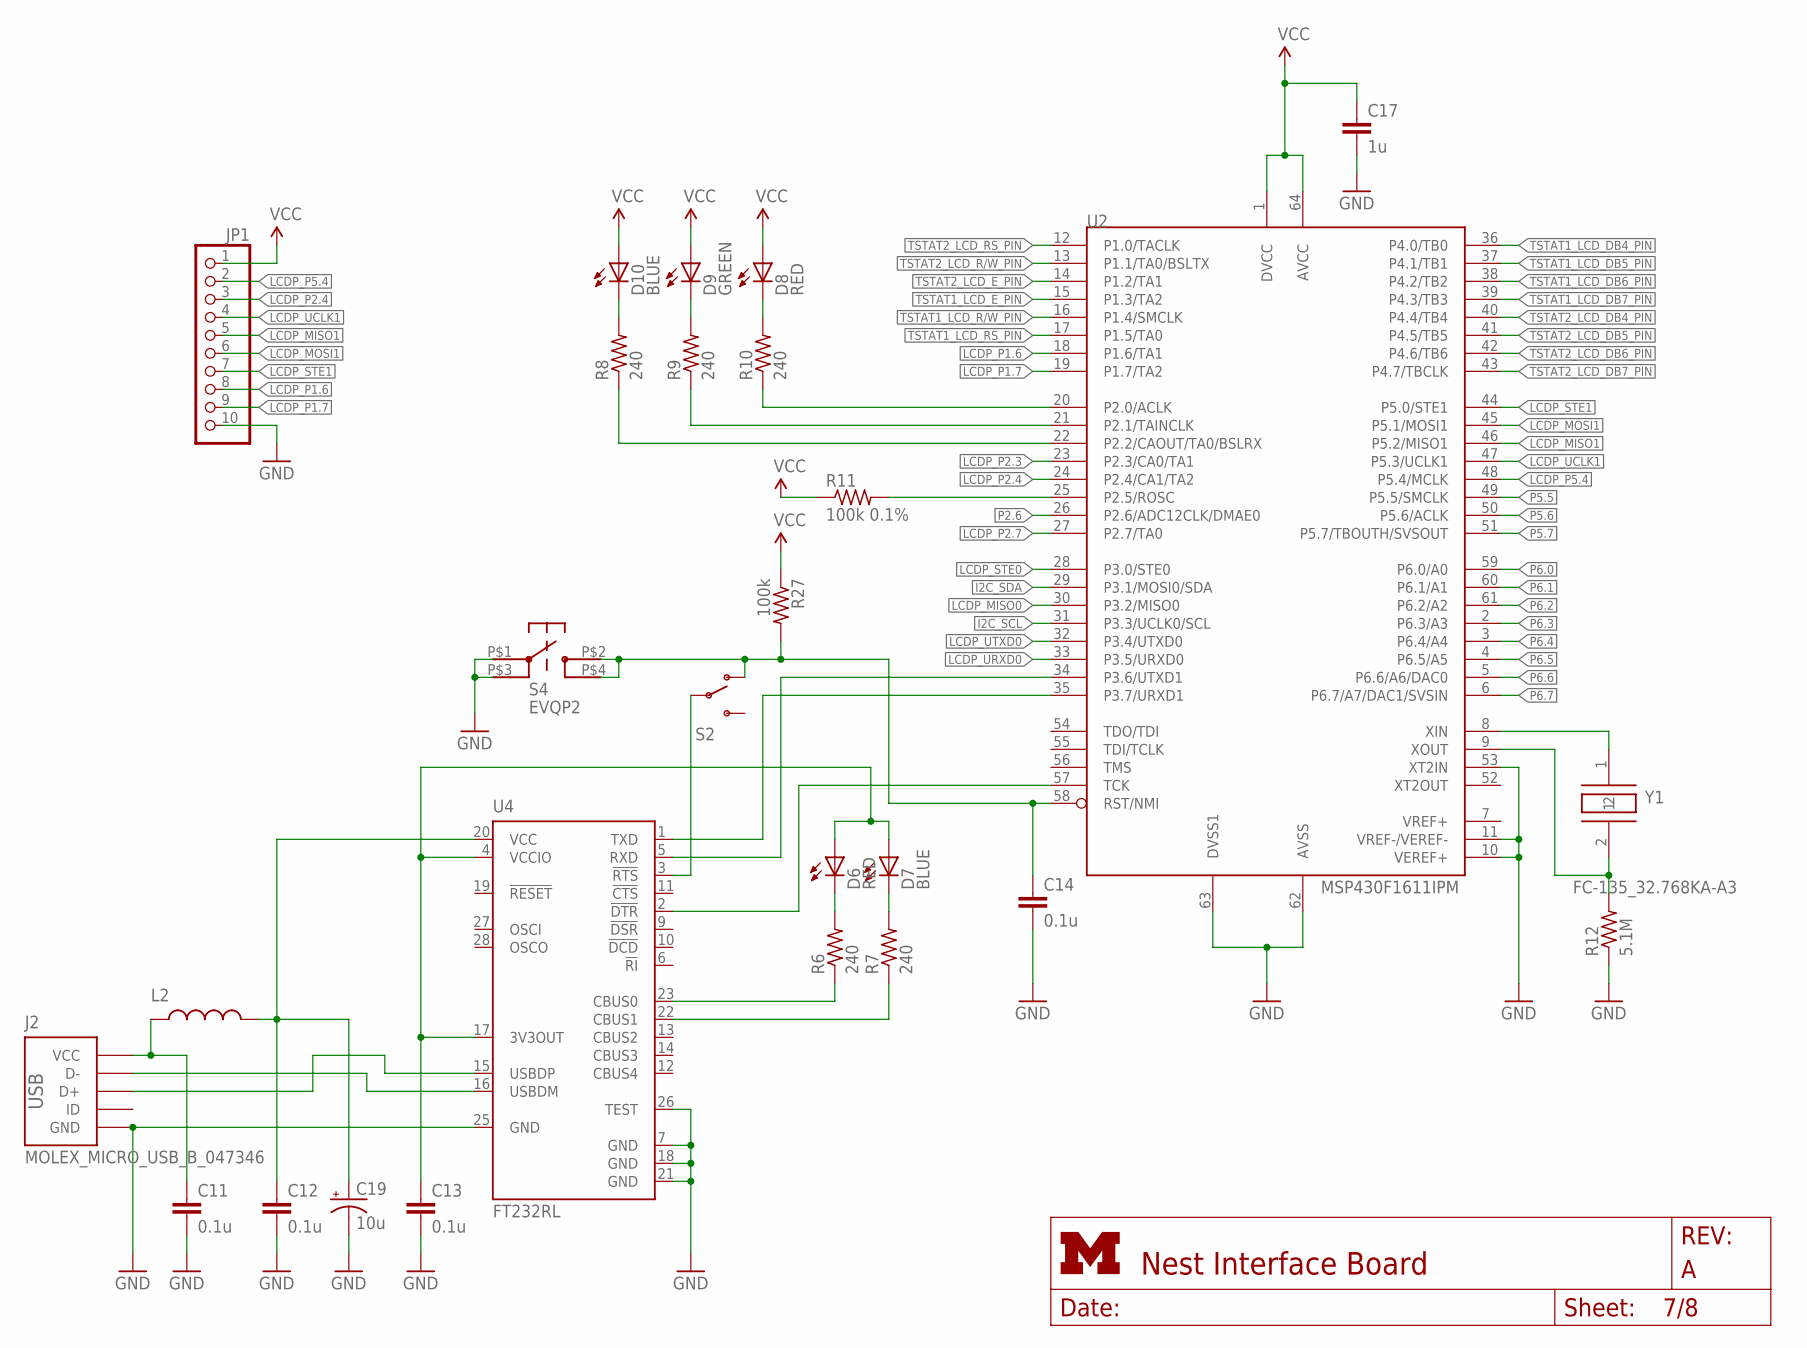
[picture p9: schematic nest_interface_a.sch, sheet 7, LCD Sniffer]

Parts:
C11, C12, C13, C14: 0.1u; C0603
C17: 1u; C0603
C19: 10u; EIA3216; DIGIKEY 478-1655-1-ND
D6, D8: RED; LED-0603
D7, D10: BLUE; LED-0603
D9: GREEN; LED-0603
J2: MOLEX_MICRO_USB_B_047346
JP1: PINHD-1X10; 1X10
L2: INDUCTOR0603; 0603; DIGIKEY 240-2373-1-ND
R6, R7, R8, R9, R10: 240; R0603
R11: 100k 0.1%; R0603
R12: 5.1M; R0603
R27: 100k; R0603
S2: SWITCH-SPSTPTH; SWITCH-SPDT; DIGIKEY EG1903-ND
S4: EVQP2; DIGIKEY P11084SCT-ND
U2: MSP430F1611IPM; PM/PAG64
U4: FT232RL; SSOP28; DIGIKEY 768-1007-1-ND
Y1: FC-135_32.768KA-A3; FC-135; DIGIKEY 535-9543-1-ND

Connections:
GND: C11.2, C12.2, C13.2, C14.2, C17.2, C19.C (-), J2.GND, JP1.10, R12.1, S4.P$1, S4.P$3, U2.10 (VEREF+), U2.11 (VREF-/VEREF-), U2.53 (XT2IN), U2.62 (AVSS), U2.63 (DVSS1), U4.7 (GND), U4.18 (GND), U4.21 (GND), U4.25 (GND), U4.26 (TEST); also elsewhere on the board
I2C_SCL: U2.31 (P3.3/UCLK0/SCL); also elsewhere on the board
I2C_SDA: U2.29 (P3.1/MOSI0/SDA); also elsewhere on the board
LCDP_MISO0: U2.30 (P3.2/MISO0)
LCDP_MISO1: JP1.5, U2.46 (P5.2/MISO1)
LCDP_MOSI1: JP1.6, U2.45 (P5.1/MOSI1)
LCDP_P1.6: JP1.8, U2.18 (P1.6/TA1)
LCDP_P1.7: JP1.9, U2.19 (P1.7/TA2)
LCDP_P2.3: U2.23 (P2.3/CA0/TA1)
LCDP_P2.4: JP1.3, U2.24 (P2.4/CA1/TA2)
LCDP_P2.7: U2.27 (P2.7/TA0)
LCDP_P5.4: JP1.2, U2.48 (P5.4/MCLK)
LCDP_STE0: U2.28 (P3.0/STE0)
LCDP_STE1: JP1.7, U2.44 (P5.0/STE1)
LCDP_UCLK1: JP1.4, U2.47 (P5.3/UCLK1)
LCDP_URXD0: U2.33 (P3.5/URXD0)
LCDP_UTXD0: U2.32 (P3.4/UTXD0)
unnamed: R10.1, U2.20 (P2.0/ACLK)
unnamed: D8.C, R10.2
unnamed: U2.8 (XIN), Y1.1
unnamed: C11.1, J2.VCC, L2.1
unnamed: J2.D-, U4.16 (USBDM)
unnamed: J2.D+, U4.15 (USBDP)
unnamed: C12.1, C19.A (+), L2.2, U4.20 (VCC)
unnamed: R6.1, U4.23 (CBUS0)
unnamed: R7.1, U4.22 (CBUS1)
unnamed: D6.C, R6.2
unnamed: D7.C, R7.2
unnamed: U2.35 (P3.7/URXD1), U4.1 (TXD)
unnamed: U2.34 (P3.6/UTXD1), U4.5 (RXD)
unnamed: U2.57 (TCK), U4.2 (!DTR)
unnamed: C13.1, D6.A, D7.A, U4.4 (VCCIO), U4.17 (3V3OUT)
unnamed: R12.2, U2.9 (XOUT), Y1.2
unnamed: D9.C, R9.2
unnamed: R11.2, U2.25 (P2.5/ROSC)
unnamed: D10.C, R8.2
unnamed: R9.1, U2.21 (P2.1/TAINCLK)
unnamed: R8.1, U2.22 (P2.2/CAOUT/TA0/BSLRX)
P2.6: U2.26 (P2.6/ADC12CLK/DMAE0)
P5.5: U2.49 (P5.5/SMCLK)
P5.6: U2.50 (P5.6/ACLK)
P5.7: U2.51 (P5.7/TBOUTH/SVSOUT)
P6.0: U2.59 (P6.0/A0)
P6.1: U2.60 (P6.1/A1)
P6.2: U2.61 (P6.2/A2)
P6.3: U2.2 (P6.3/A3)
P6.4: U2.3 (P6.4/A4)
P6.5: U2.4 (P6.5/A5)
P6.6: U2.5 (P6.6/A6/DAC0)
P6.7: U2.6 (P6.7/A7/DAC1/SVSIN)
RST1: C14.1, R27.2, S2.1 (O), S4.P$2, S4.P$4, U2.58 (RST/NMI)
RST_USB1: S2.2, U4.3 (!RTS)
TSTAT1_LCD_DB4_PIN: U2.36 (P4.0/TB0); also elsewhere on the board
TSTAT1_LCD_DB5_PIN: U2.37 (P4.1/TB1); also elsewhere on the board
TSTAT1_LCD_DB6_PIN: U2.38 (P4.2/TB2); also elsewhere on the board
TSTAT1_LCD_DB7_PIN: U2.39 (P4.3/TB3); also elsewhere on the board
TSTAT1_LCD_E_PIN: U2.15 (P1.3/TA2); also elsewhere on the board
TSTAT1_LCD_R/W_PIN: U2.16 (P1.4/SMCLK); also elsewhere on the board
TSTAT1_LCD_RS_PIN: U2.17 (P1.5/TA0); also elsewhere on the board
TSTAT2_LCD_DB4_PIN: U2.40 (P4.4/TB4); also elsewhere on the board
TSTAT2_LCD_DB5_PIN: U2.41 (P4.5/TB5); also elsewhere on the board
TSTAT2_LCD_DB6_PIN: U2.42 (P4.6/TB6); also elsewhere on the board
TSTAT2_LCD_DB7_PIN: U2.43 (P4.7/TBCLK); also elsewhere on the board
TSTAT2_LCD_E_PIN: U2.14 (P1.2/TA1); also elsewhere on the board
TSTAT2_LCD_R/W_PIN: U2.13 (P1.1/TA0/BSLTX); also elsewhere on the board
TSTAT2_LCD_RS_PIN: U2.12 (P1.0/TACLK); also elsewhere on the board
VCC: C17.1, D8.A, D9.A, D10.A, JP1.1, R11.1, R27.1, U2.1 (DVCC), U2.64 (AVCC); also elsewhere on the board

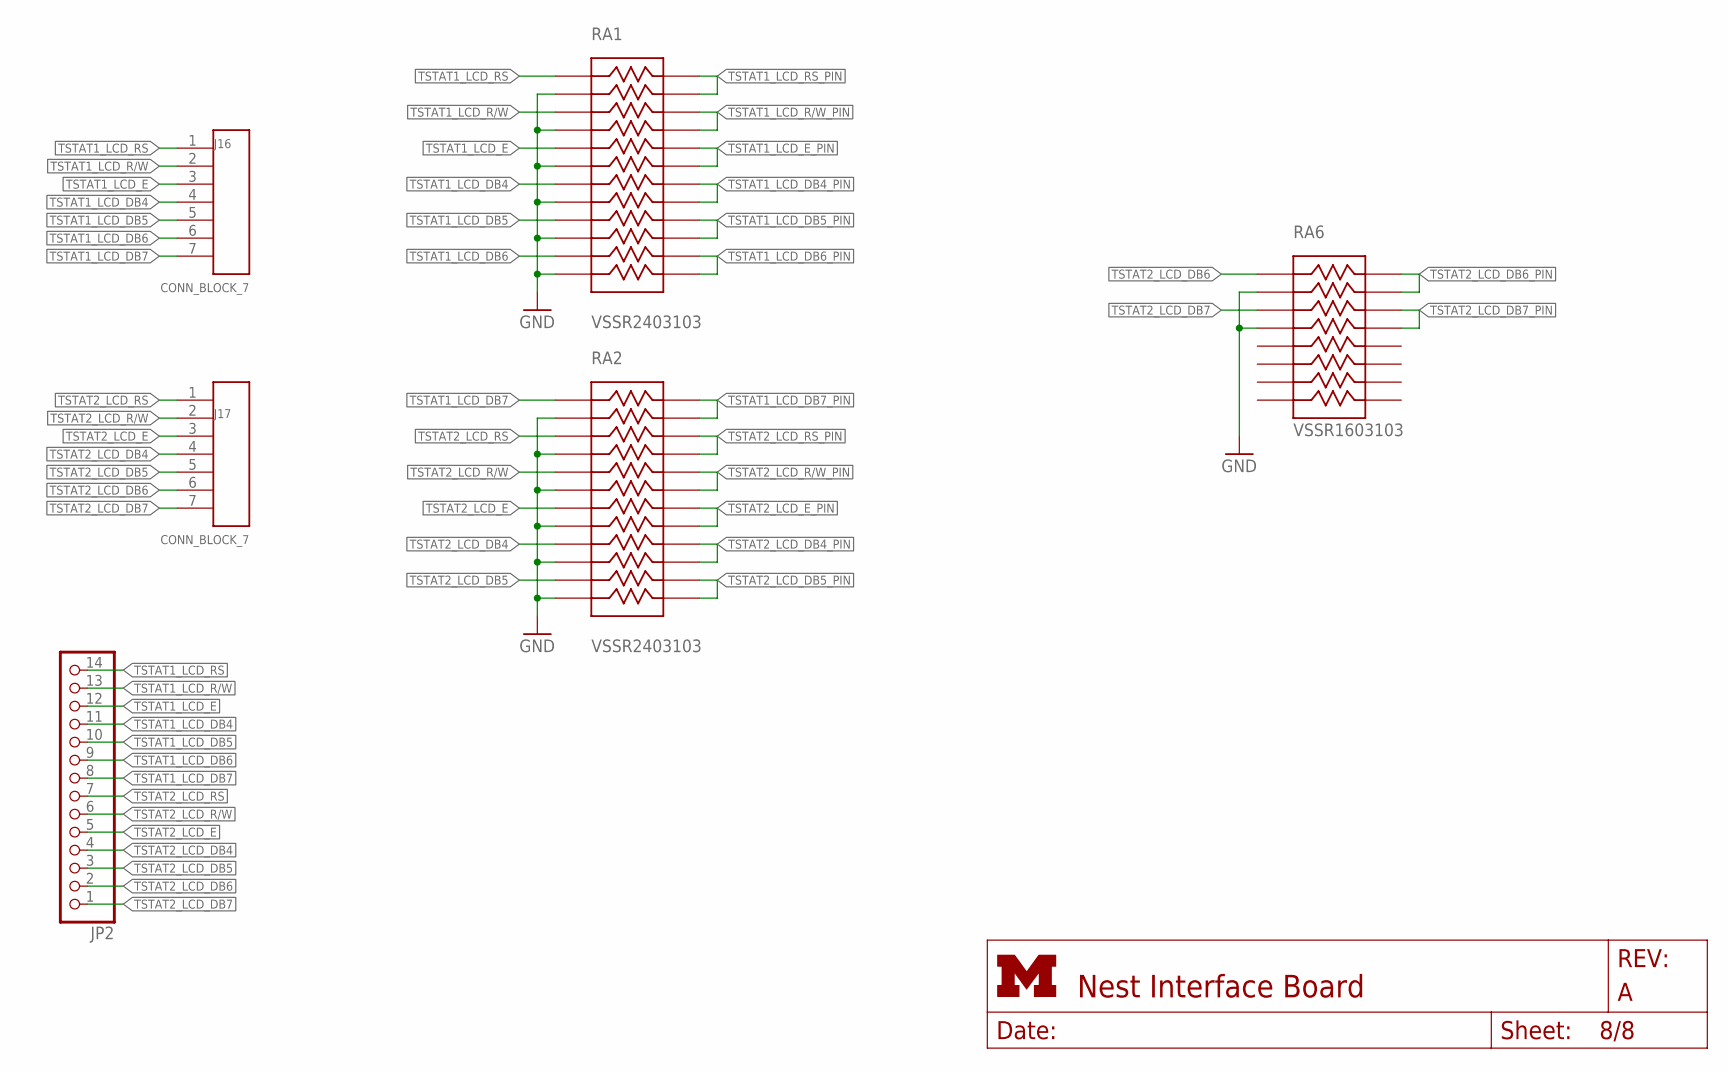
[picture p10: schematic nest_interface_a.sch, sheet 8, LCD I/O]

Parts:
J16, J17: CONN_BLOCK_7
JP2: PINHD-1X14; 1X14
RA1, RA2: VSSR2403103; LSSOP-24
RA6: VSSR1603103; LSSOP-16

Connections:
GND: RA1.2, RA1.4, RA1.6, RA1.8, RA1.10, RA1.12, RA2.2, RA2.4, RA2.6, RA2.8, RA2.10, RA2.12, RA6.2, RA6.4; also elsewhere on the board
TSTAT1_LCD_DB4: J16.4, JP2.11, RA1.7
TSTAT1_LCD_DB4_PIN: RA1.17, RA1.18; also elsewhere on the board
TSTAT1_LCD_DB5: J16.5, JP2.10, RA1.9
TSTAT1_LCD_DB5_PIN: RA1.15, RA1.16; also elsewhere on the board
TSTAT1_LCD_DB6: J16.6, JP2.9, RA1.11
TSTAT1_LCD_DB6_PIN: RA1.13, RA1.14; also elsewhere on the board
TSTAT1_LCD_DB7: J16.7, JP2.8, RA2.1
TSTAT1_LCD_DB7_PIN: RA2.23, RA2.24; also elsewhere on the board
TSTAT1_LCD_E: J16.3, JP2.12, RA1.5
TSTAT1_LCD_E_PIN: RA1.19, RA1.20; also elsewhere on the board
TSTAT1_LCD_R/W: J16.2, JP2.13, RA1.3
TSTAT1_LCD_R/W_PIN: RA1.21, RA1.22; also elsewhere on the board
TSTAT1_LCD_RS: J16.1, JP2.14, RA1.1
TSTAT1_LCD_RS_PIN: RA1.23, RA1.24; also elsewhere on the board
TSTAT2_LCD_DB4: J17.4, JP2.4, RA2.9
TSTAT2_LCD_DB4_PIN: RA2.15, RA2.16; also elsewhere on the board
TSTAT2_LCD_DB5: J17.5, JP2.3, RA2.11
TSTAT2_LCD_DB5_PIN: RA2.13, RA2.14; also elsewhere on the board
TSTAT2_LCD_DB6: J17.6, JP2.2, RA6.1
TSTAT2_LCD_DB6_PIN: RA6.15, RA6.16; also elsewhere on the board
TSTAT2_LCD_DB7: J17.7, JP2.1, RA6.3
TSTAT2_LCD_DB7_PIN: RA6.13, RA6.14; also elsewhere on the board
TSTAT2_LCD_E: J17.3, JP2.5, RA2.7
TSTAT2_LCD_E_PIN: RA2.17, RA2.18; also elsewhere on the board
TSTAT2_LCD_R/W: J17.2, JP2.6, RA2.5
TSTAT2_LCD_R/W_PIN: RA2.19, RA2.20; also elsewhere on the board
TSTAT2_LCD_RS: J17.1, JP2.7, RA2.3
TSTAT2_LCD_RS_PIN: RA2.21, RA2.22; also elsewhere on the board

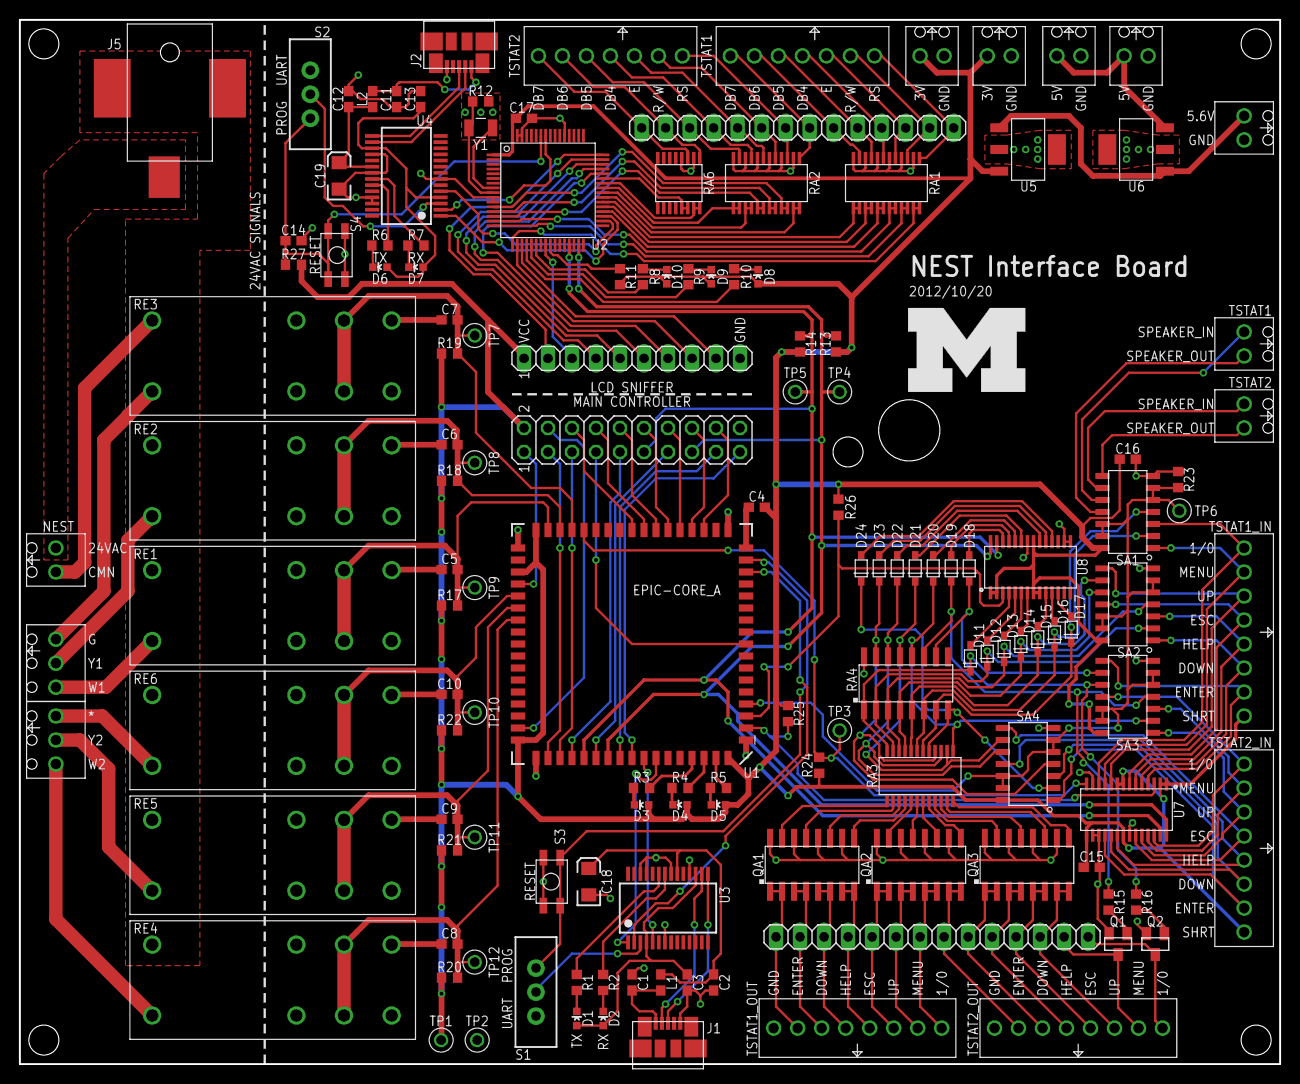
[picture p11: board nest_interface_a.brd from above]

Board: 2 copper layers, 133.3 x 110.5 mm, 141 parts (0 on the bottom side), 194 nets.
