bradjc/thermostat/lcd_sniffer/src/peripherals/gpio.c

#include <msp430.h>
#include <inttypes.h>
#include <stddef.h>

#include "gpio.h"

// Array to hold the callback functions for the interrupt on each pin.
// Ports 1 and 2 are interrupt pins.
gpio_int_cb* cb_array[16] = {NULL};
gpio_int_cb* main_cb;

void gpio_init (uint8_t port, uint8_t pin, gpio_dir_e dir) {
	uint8_t set, clear;

	clear = ~(1 << pin);

	if (dir == GPIO_OUT) {
		set = 1 << pin;
	} else if (dir == GPIO_IN) {
		set = 0;
	}

	switch (port) {
		case 1: P1DIR = (P1DIR & clear) | set; break;
		case 2: P2DIR = (P2DIR & clear) | set; break;
		case 3: P3DIR = (P3DIR & clear) | set; break;
		case 4: P4DIR = (P4DIR & clear) | set; break;
	}
}

void gpio_interrupt (uint8_t port,
                     uint8_t pin,
                     gpio_int_dir_e int_dir,
                     gpio_int_cb cb) {

	uint8_t clear, set_int_dir = 0;

	clear = ~(1 << pin);

	if (int_dir == GPIO_INT_FALLING_EDGE) {
		set_int_dir = (1 << pin);
	}

	switch (port) {
	  case 1:
		P1DIR &= clear;                         // set as input
		P1SEL &= clear;                         // set as I/O pin
		P1IES = (P1IES & clear) | set_int_dir;  // set the transistion
		P1IFG &= clear;                         // clear any interrupt
		P1IE  |= (1 << pin);                    // enable the interrupt
	  case 2:
		P2DIR &= clear;                         // set as input
		P2SEL &= clear;                         // set as I/O pin
		P2IES = (P1IES & clear) | set_int_dir;  // set the transistion
		P2IFG &= clear;                         // clear any interrupt
		P2IE  |= (1 << pin);                    // enable the interrupt
	}

	if (cb != NULL) {
		cb_array[(port-1)*8 + pin] = cb;
	}

//	main_cb = cb;

}

void gpio_set_clear (uint8_t port, uint8_t pin, uint8_t set) {
	uint8_t clear;

	set = (set & 0x01) << pin;
	clear = ~(1 << pin);
	switch (port) {
		case 1: P1OUT = (P1OUT & clear) | set; break;
		case 2: P2OUT = (P2OUT & clear) | set; break;
		case 3: P3OUT = (P3OUT & clear) | set; break;
		case 4: P4OUT = (P4OUT & clear) | set; break;
	}
}

void gpio_set (uint8_t port, uint8_t pin) {
	gpio_set_clear(port, pin, 1);
}

void gpio_clear (uint8_t port, uint8_t pin) {
	gpio_set_clear(port, pin, 0);
}

void gpio_toggle(uint8_t port, uint8_t pin) {
	if (gpio_read(port, pin)) {
		gpio_clear(port, pin);
	} else {
		gpio_set(port, pin);
	}
}

uint8_t gpio_read(uint8_t port, uint8_t pin) {
	switch (port) {
		case 1:
			return (P1IN >> pin) & 0x01;
		case 2:
			return (P2IN >> pin) & 0x01;
		case 3:
			return (P3IN >> pin) & 0x01;
		case 4:
			return (P4IN >> pin) & 0x01;
	}
	return 0;
}

uint8_t one_hot_to_binary (uint8_t a) {
	switch (a) {
		case 0x0: return 0;
		case 0x1: return 1;
		case 0x2: return 2;
		case 0x4: return 3;
		case 0x8: return 4;
		case 0x10: return 5;
		case 0x20: return 6;
		case 0x40: return 7;
		case 0x80: return 8;
	}
	return 0;
}

/*
#pragma vector=PORT1_VECTOR
__interrupt void Port_1(void) {
	uint8_t pin;
	uint8_t pin_int;

	P1IFG = 0;
	main_cb();

//	P2OUT ^= 0x10;
	return;

	pin = P1IFG;
	P1IFG = 0;
	if (pin == 0x08) {
		cb_array[4]();
		return;
	}

	pin_int = one_hot_to_binary(pin) - 1;
	if (cb_array[pin_int] != NULL) {
		cb_array[pin_int]();
	}
}
*/
#pragma vector=PORT2_VECTOR
__interrupt void Port_2(void) {

	uint8_t pin_int;
	pin_int = one_hot_to_binary(P2IFG) + 7;
	P2IFG = 0;
	if (cb_array[pin_int] != NULL) {
		cb_array[pin_int]();
	}
}
