bradjc/thermostat/lcd_sniffer/src/include/utility.h

#ifndef __UTILITY_H__
#define __UTILITY_H__

#include <msp430.h>
#include <inttypes.h>
#include <stdio.h>


#define IDLE_CYCLES 4
// Used by the coding state machine to identify
// long and short pulses.
#define THRESHOLD 4
#define DELTAT 13


// Disables the watchdog timer
void util_disableWatchdog(void);
void util_boardInit(void);
void util_enableInterrupt(void);
void util_disableInterrupt(void);
void util_delayMs(uint16_t ms);

// DO NOT USE THIS FUNCTION
// unless you want to delay less than a MS
void util_delayCycles (uint16_t cycles);


#define LCD_SNIFF_I2C_ADDR 0x44

#define FALSE 0
#define TRUE  1

#define TSTAT1_LCD_RS_PORT  1
#define TSTAT1_LCD_RS_PIN   5
#define TSTAT1_LCD_E_PORT   1
#define TSTAT1_LCD_E_PIN    3
#define TSTAT1_LCD_RW_PORT  1
#define TSTAT1_LCD_RW_PIN   4
#define TSTAT1_LCD_DB4_PORT 4
#define TSTAT1_LCD_DB4_PIN  0
#define TSTAT1_LCD_DB5_PORT 4
#define TSTAT1_LCD_DB5_PIN  1
#define TSTAT1_LCD_DB6_PORT 4
#define TSTAT1_LCD_DB6_PIN  2
#define TSTAT1_LCD_DB7_PORT 4
#define TSTAT1_LCD_DB7_PIN  3

#define TSTAT2_LCD_RS_PORT  1
#define TSTAT2_LCD_RS_PIN   0
#define TSTAT2_LCD_E_PORT   1
#define TSTAT2_LCD_E_PIN    2
#define TSTAT2_LCD_RW_PORT  1
#define TSTAT2_LCD_RW_PIN   6
#define TSTAT2_LCD_DB4_PORT 4
#define TSTAT2_LCD_DB4_PIN  4
#define TSTAT2_LCD_DB5_PORT 4
#define TSTAT2_LCD_DB5_PIN  5
#define TSTAT2_LCD_DB6_PORT 4
#define TSTAT2_LCD_DB6_PIN  6
#define TSTAT2_LCD_DB7_PORT 4
#define TSTAT2_LCD_DB7_PIN  7

typedef uint8_t bool;

typedef enum {
	TSTAT1 = 0,
	TSTAT2 = 1,
} thermostat_e;


#endif
