bradjc/thermostat/(commit log)

2012-04-07 added window display and svnstat stuff to the shed-extra git repo
    [config.txt]
2012-04-08 try this again
    [config.txt]
2012-04-08 couple tweaks to the new window display
2012-04-25 adding printer query stuff
2012-04-25 printer script should work again
2012-09-28 nest interface board!!
    [nest_interface_a.brd, nest_interface_a.sch]
2012-09-29 started routing the nest interface board
    [nest_interface_a.brd, nest_interface_a.sch]
2012-09-29 routed the nest interface board
    [nest_interface_a.brd, nest_interface_a.sch]
2012-09-29 added silkscreen to nest board
    [nest_interface_a.brd, nest_interface_a.sch]
2012-10-02 tweaks to nest interface board
    [nest_interface_a.brd, nest_interface_a.sch]
2012-10-02 adding more relays to the nest interface board in
    prep for v2
    [nest_interface_a.brd, nest_interface_a.sch]
2012-10-03 added relays
    [nest_interface_a.brd, nest_interface_a.sch]
2012-10-04 BETTER NEST
    [nest_interface_a.brd, nest_interface_a.sch]
2012-10-05 saving nest i board
    [nest_interface_a.brd, nest_interface_a.sch]
2012-10-06 started routing wow is that going to be tricky
    [nest_interface_a.brd, nest_interface_a.sch]
2012-10-07 cleaning up schematic/bom
    [nest_interface_a.brd, nest_interface_a.sch, nest_interface_a_bom.xlsx]
2012-10-08 cleaned up the nib schematic
    [nest_interface_a.brd, nest_interface_a.sch, nest_interface_a_bom.xlsx]
2012-10-08 updated bom
    [nest_interface_a.sch, nest_interface_a_bom.xlsx]
2012-10-08 more schematic updates
    [nest_interface_a.brd, nest_interface_a.sch, nest_interface_a_bom.xlsx]
2012-10-08 MOAR ROUTING
    [nest_interface_a.brd]
2012-10-08 no airwires!!!!!
    [nest_interface_a.brd, nest_interface_a.sch]
2012-10-09 labels cleaned up, looks good
    [nest_interface_a.brd, nest_interface_a.sch]
2012-10-09 added decoupling caps, bom
    [nest_interface_a.brd, nest_interface_a.sch, nest_interface_a_bom.xlsx]
2012-10-09 added board for keypad socket
    [keypad_socket_a.brd, keypad_socket_a.sch, nest_interface_a.brd, nest_interface_a.sch, nest_interface_a_bom.xlsx]
2012-10-11 cleaned up two traces and started lcd code
    [nest_interface_a.brd]
2012-10-15 board changes, lcd code
    [nest_interface_a.brd, nest_interface_a.sch]
2012-10-16 nib: before big keypad control change
    [nest_interface_a.brd, nest_interface_a.sch]
2012-10-17 new ciruict routed - no airwires
    [nest_interface_a.brd, nest_interface_a.sch]
2012-10-17 slight fixes
    [nest_interface_a.brd, nest_interface_a.sch]
2012-10-17 board looks pretty nice
    [nest_interface_a.brd]
2012-10-20 board may actually be done
    [nest_interface_a.brd, nest_interface_a.sch]
2012-10-20 ok a couple more fixes
    [nest_interface_a.brd]
2012-10-26 added nest interface stencil
    [nest_interface_a_mm.dxf]
2012-10-26 added nest stencil file
    [nest_interface_a_mm.dxf]
2012-10-26 fixed nest stencil pitch
    [nest_interface_a_mm.dxf]
2012-11-20 updated to rev b
    fixed the programmer for the lcd sniffer msp
    [nest_interface_b.brd, nest_interface_b.sch]
2012-11-26 got a start on multi button press, doesnt seem to work yet
    probably need to change the set interface to something with a callback
2012-11-26 added set done to thermostat pins setting this should allow multiple button presses to work
2012-11-26 setting ignores
    updated multiple button module for nest board
2012-11-26 updated rev b of the nest board
2012-11-26 added a disable/enable interface to the input buttons so you dont get interrupts while setting output pins
2012-11-28 moved gpio interrupt to pin2.7
    [nest_interface_b.brd, nest_interface_b.sch]
2012-12-18 working on new thermostat button architecture
2012-12-18 renamed multi button
2012-12-18 much better architecture for nest output buttons
2012-12-19 tested with everything except the i2c connection to the lcd sniffer
2012-12-19 added a delay after each button press
2012-12-20 fuck fuck fuck
    [nest_interface_b.brd, nest_interface_b.sch]
2012-12-20 nest board
2013-01-03 Refactored button input code into the better generic style.
    Adding comments.
2013-01-14 ignores and a first pass on the tinyos cc2520rpi driver
    I've gotten the cc2520rpi driver to compile...but that's about it. I'm not sure all of the files I created will make it into the final version as I'm not quite sure what is handled in tinyos and what's in the driver. I assume much of what I'm doing now will have to be replaced or moved, but that is OK.
    Oh, and FUCK SVN.
2013-02-01 receiver stand 3d models
    [corner.ipt, corner.stl, side.ipt, side.stl]
2013-02-01 moving so all my files are in one commit
    [keypad_socket_a.brd, keypad_socket_a.sch, nest_interface_a.brd, nest_interface_a.sch, nest_interface_a_bom.xlsx, nest_interface_a_mm.dxf, nest_interface_b.brd, nest_interface_b.sch]
2013-02-01 moving so all my files are in one commit
    Conflicts:
    nib/docs/TM162ad_lcd_module.pdf
    nib/docs/ffc_thru-hole_10pos_0.100in.pdf
    nib/docs/ideas.txt
    nib/docs/pca9575.pdf
    nib/eagle/keypad_socket/rev_a/keypad_socket_a.brd
    nib/eagle/keypad_socket/rev_a/keypad_socket_a.sch
    nib/eagle/nest_interface.lbr
    nib/eagle/rev_a/nest_interface_a.brd
    nib/eagle/rev_a/nest_interface_a.sch
    nib/eagle/rev_a/nest_interface_a_bom.xlsx
    nib/eagle/rev_a/nest_interface_a_mm.dxf
    nib/eagle/rev_a/nest_interface_a_to_fab_2012-10-20.zip
    nib/eagle/rev_a/nest_interface_a_to_fab_2012-10-26.zip
    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
    [keypad_socket_a.brd, keypad_socket_a.sch, nest_interface_a.brd, nest_interface_a.sch, nest_interface_a_bom.xlsx, nest_interface_a_mm.dxf, nest_interface_b.brd, nest_interface_b.sch]
2013-02-01 Got them in there
    [config.txt, corner.ipt, corner.stl, keypad_socket_a.brd, keypad_socket_a.sch, nest_interface_a.brd, nest_interface_a.sch, nest_interface_a_bom.xlsx]
2013-02-05 lcd sniffer seems to respond correctly
    [i2c.c, main.c]
2013-02-05 i2c gpio actually get itited now
2013-02-05 updated app to blink led
2013-02-05 testing i2c
2013-02-09 reads lcd properly
    Code is an absolute mess, but I figured out the timing issues and the
    lcd sniffer can now read the lcd correctly. I need to add in the lcd
    status code and clean it up but this nest board is now really close to
    being real!
    [gpio.c, i2c.c, i2c.h, lcd_state.c, lcd_state.h, main.c, utility.c]
2013-02-10 nest duty cycle works
    Need to change the lcd state code to work on lines and not screens. It's
    not uncommon for the lines on screen to become flipped.
    [lcd_state.c]
2013-02-10 Changed lcd sniffer to handle lines
    No longer tries to maintain what is on the entire screen.
    [lcd_state.c, lcd_state.h, main.c]
2013-02-12 fixed enable/disable for input pins
    Now you can disable a single bank of input pins
    [nib.h]
2013-02-12 Fixed I2C bug where .granted() was problematic
    The state machine was getting triggered when I didn't expect it, causing
    upper layers to get signaled spuriously. I still think there is a bug in
    the msp i2c code or in nesc, because i don't know why .granted() was
    getting called when the i2c_state == I2C_ST_SET_PIN2.
2013-02-14 State machine improvement
    Added a null state just in case any weirdness happens
2013-02-18 added timer to periodically reconfigure gpio ext
    Every minute reprograms the gpio extenders
2014-01-16 folder tree correct
    [nest_interface_a.brd, nest_interface_a.sch, nest_interface_a_bom.xlsx, nest_interface_a_mm.dxf, nest_interface_b.brd, nest_interface_b.sch]
